Oleg-mk/JLR-MOST-Reader/kit/1_boards/README.md

# Плати: замовлення, деталі, монтаж

| Файл | Що це |
|---|---|
| `most_reader-gerbers.zip` | сама плата для фабрики: Gerber-файли, свердління, файл задачі |
| `most_reader-bom-jlcpcb.csv` | перелік деталей для монтажу SMD у JLCPCB, з номерами LCSC |
| `most_reader-cpl-jlcpcb.csv` | розміщення для JLCPCB, з їхніми поворотами |
| `most_reader-bom.csv` | повний перелік деталей, разом із ручними |
| `most_reader-schematic.pdf` | схема |
| `most_reader-assembly.pdf` | креслення верхнього боку: позначення всіх деталей (і восьми, яких не видно на шовкографії), знаки полярності, контур |

Ці файли — копії з `reader_hw/fab`. Їх пише `reader_hw/make_fab.py` з плати KiCad, руками не
правити.

## Плата

- 77.5 x 55.6 мм, 2 шари, FR-4 1.6 мм, мідь 1 oz з обох боків. JLCPCB покаже 77.6 x 55.7 мм, бо
  рахує контур разом із товщиною лінії.
- Доріжки від 0.2 мм, зазор 0.15 мм, найменший отвір 0.3 мм, вирізів немає.
- Маска з обох боків, шовкографія лише зверху. Покриття ENIG: U4 (VSSOP-8, крок 0.5 мм), U5
  (WSON-6) і U6 (HSOP-8) потребують плоских площадок.

## Замовлення на JLCPCB

1. **Плата.** Завантажити `most_reader-gerbers.zip`. Вибрати: 2 шари, 1.6 мм, 1 oz, ENIG, зелена
   маска, білий друк, кількість (10 для початку).
2. **Монтаж.** Лише верхній бік, «Confirm parts placement» увімкнути, своїх деталей не давати.
3. **BOM і CPL.** Завантажити `most_reader-bom-jlcpcb.csv` і `most_reader-cpl-jlcpcb.csv`: 28 рядків,
   усі з номерами LCSC, 50 деталей на плату. JLCPCB одразу покаже наявність. Якої деталі не
   вистачає, ту докупити з LCSC на тій самій сторінці.
4. **Перегляд розміщення перед оплатою.** Перевірити:
   - першу ніжку U1, U3 (SOT-353), U4 (VSSOP-8), U5 (WSON-6) і U6 (HSOP-8);
   - полярність D1, D2, D3, C44, C45 і C63.

   Повороти взято з посадок LCSC кожної вибраної деталі. Крапка першої ніжки U4 має стояти на
   позначці першої ніжки плати, а «+» кожного електроліта на боці «+» шовкографії.

## Деталі для ручного монтажу

На одну плату:

| Позиція | Деталь | Номер | Де купити |
|---|---|---|---|
| J1 | оптичний модуль MOST (pigtail FOT, 2+0) | TE 1-1394640-1 | у каталогах Mouser і DigiKey не знайдено, лише маркетплейси: шукати заздалегідь |
| J4 | Micro-Fit 3.0, 2 контакти, кутовий | Molex 43650-0200 | будь-який дистриб'ютор Molex |
| J6 | передавач TOSLINK, корпус T10 | Everlight PLT237/T10WH | DigiKey 1080-PLT237/T10WH-ND; у LCSC — C17296340 |
| M1 | модуль FPGA | Sipeed Tang Nano 20K | магазин Sipeed |
| — | гребінки 1x20 з кроком 2.54 мм, 2 шт. | — | зазвичай ідуть з модулем |

Отвори зроблено саме під ці деталі, схожі можуть не стати.

## Що ще потрібно, крім плати

- **Живлення J4:** корпус Molex 43645-0200 і два контакти 43030 (провід 20–24 AWG). Живити від
  постійного «плюса» акумулятора (KL30) і маси. Без живлення обхід не працює, і кільце машини
  розірване. Біля точки підключення до проводки машини варто поставити свій запобіжник: F1 на
  платі (2 А) захищає лише те, що за ним, а не провід.
- **Вставка в кільце MOST:** кабель, що розриває кільце біля одного з вузлів і заводить його на
  J1, а оптика назад іде насквозь. У репозиторії номера немає; такі кабелі роблять Kufatec,
  Dension, Trioma, і підбирати його треба під свій вузол.
- **Оптичний кабель TOSLINK** від J6 до DSP або підсилювача.
- **4 гвинти M3 або стійки** для H1..H4: довкола отворів лише земля.
- **Для стола** потрібне світло в J1: живе кільце машини або інша плата MOST. Без нього FPGA не
  отримує живлення від плати.

## Монтаж

1. Перед запаюванням записати в модуль Tang Nano 20K прошивку, через його USB-C, без плати
   (`2_fpga/README.md`).
2. J1, J4 і J6 паяти в будь-якому порядку, M1 останнім. Для M1: гребінки вставити в плату,
   модуль зверху, спершу паяти модуль, потім плату. Без панельок.
3. Орієнтація:
   - **M1:** квадратна площадка 1 і USB-C до верхнього краю, кінець із HDMI виступає за нижній
     край на 8 мм. Розвернутий на 180° модуль сів би землею на 5 В.
   - **J1:** площадка 1 (TXD) прямокутна, оптична грань за лівим краєм.
   - **J6:** порт до правого краю, виступає за нього на 2.35 мм, фіксатори перед ніжками.
     Площадка 1 (Vin) квадратна.
   - **J4:** площадка 1 (нижня, із заокругленими кутами) — VBAT, площадка 2 — GND. На шовкографії
     полярність не позначено.
4. Вісім дрібних позначень на шовкографії не вмістилися (C10, C17, C18, FB2, R1, R7, C47, C84).
   Вони є на кресленні монтажу.

## Перед першим живленням

- Оглянути все за списком із кроку 4 замовлення.
- Омметром перевірити, що немає короткого: J4 між 1 і 2, TP6 (3V3_AON) до TP9/TP10 (GND), TP7
  (5V_SW) до GND.
- Контакти 19 і 36 модуля (його власні 3.3 В) ні з чим не з'єднані. Так задумано.

## Перше живлення

1. J4 від лабораторного джерела 12 В з обмеженням струму: перевернута полярність пропалить F1.
2. TP6 має показати 3.3 В (U5, є завжди). Без світла в J1 сигнал WAKE = 0 і U6 вимкнено, тож
   TP7 = 0 В — так і має бути. Струм спокою — десятки мікроампер.
3. Зі світлом у J1 TP7 показує близько 5.3 В, модуль отримує близько 5.0 В через D3.
4. Коли FPGA стартує, з'являється 3V3_SW (ніжка 7 модуля, живлення J6): близько 3.2 В, не менше
   2.8 В.
   Світлодіоди модуля горять нулем:
   - LED1 не світить: його ніжка живить 3V3_SW;
   - LED0 — кільце захоплено;
   - LED2 — іде потік кадрів;
   - LED3 — парність відома;
   - LED4 — блимає на кожне наше повідомлення;
   - LED5 — викинутий блок або перевантаження.
5. Далі стіл із ноутбуком: `3_laptop/README.md`, «Перед машиною».

## У машині

Спершу лише обхід: зчитувач у кільці, з живленням, а машина звучить як раніше. Потім уже
зчитувач із записом поїздки.
