Oleg-mk/JLR-MOST-Reader/kit/2_fpga/README.md

# FPGA зчитувача: прошивка для Tang Nano 20K

- `reader.fs` — бітстрім зчитувача для GW2AR-LV18QN88C8/I7 на модулі Sipeed Tang Nano 20K.
- `BUILD.txt` — з якого коміту його зібрано, його номер (`build_id`), UserCode, частота
  читання флешу (25 МГц) і таймінг збірки.

Бітстрім пишеться у SPI-флеш модуля. FPGA читає його звідти щоразу, коли прокидається кільце
(близько 290 мс), тож запис у флеш переживає вимкнення. Запис в SRAM для зчитувача не годиться:
він зникає разом із живленням.

`tools/make_kit.py --fpga` бере сюди лише бітстрім, зібраний із закомічених джерел і з
запасом таймінгу не менше 10 %. `check_all.py` падає, якщо джерела змінилися після цієї збірки.

## Коли заливати

Найкраще до того, як модуль запаяно в плату: модуль підключається до ноутбука USB-C, без
плати. Що робить заводська демо-прошивка модуля з ніжками 16, 27 і 42, проєкт не перевіряв.
Ніжка 16 у платі живить U3 і J6, а ніжку 27 веде U3. Пізніше прошивку можна оновлювати й у
платі тим самим USB-C.

Перед записом треба закрити `ring_log` (`record`), бо JTAG і відкритий порт моста
виключають одне одного. Після запису висмикнути й вставити USB.

## Прошивка відладчика BL616

Міст USB на модулі має власну прошивку. Потрібна версія 2025030317 або новіша: зі старішими
`openFPGALoader` не пише флеш, а порт працює вчетверо швидше, ніж задано. Як дізнатися версію:
`3_laptop/README.md`, «Перед машиною», крок 1. Оновлюється вона програмою BouffaloLabDevCube
(Windows і macOS): вибрати чип BL616/618 і вставити USB, тримаючи кнопку UPDATE за роз'ємом
HDMI. Покроково: wiki.sipeed.com, сторінка «update_debugger».

## Windows 10 або 11: Gowin Programmer

1. Gowin Programmer входить у Gowin EDA (Education, з gowinsemi.com) або ставиться окремо з
   пакета Sipeed (dl.sipeed.com, TANG, programmer). Драйвер FTDI ставиться разом із ним.
2. Модуль підключити прямо в порт ПК, без хаба. У Диспетчері пристроїв мають з'явитися
   USB Converter A, USB Converter B і COM-порт.
3. Запустити Programmer:
   - **Cable Setting:** кабель, який він знайшов (USB Debugger A), частота 2.5 МГц або менше,
     Save.
   - **Scan:** у списку вибрати **GW2AR-18C**, бо GW2A-18C і GW2ANR-18C мають той самий ID.
   - Подвійне клацання в колонці Operation, далі:
     - Access Mode: **External Flash Mode**;
     - Operation: **exFlash Erase,Program thru GAO-Bridge**;
     - File: `reader.fs`;
     - External Flash Device: **Generic Flash**;
     - Start Address: **0x000000**.
     Save, потім Program/Configure.
   - Операції з «Verify» Sipeed радить не вибирати: з цим мостом вони бувають дуже повільні або
     обриваються. Перевірка нижче.
4. Те саме з командного рядка, з папки `Programmer\bin`:

   ```bat
   programmer_cli.exe --scan-cables
   programmer_cli.exe --cable-index 4 --frequency 2.5MHz --device GW2AR-18C --run 36 --spiaddr 0x000000 --fsFile C:\шлях\до\kit\2_fpga\reader.fs
   ```

   `--cable-index` береться той, під яким `--scan-cables` показав USB Debugger A.

## macOS (і Apple Silicon): openFPGALoader

1. Встановити Homebrew (brew.sh), далі `brew install openfpgaloader`.
2. Модуль підключити до Mac. На Mac з Apple Silicon на питання про новий аксесуар відповісти
   «Дозволити».
3. Перевірити зв'язок: `openFPGALoader -b tangnano20k --detect`. Має показати idcode 0x0000081b.
4. Записати флеш:

   ```bash
   openFPGALoader -b tangnano20k -f --verify reader.fs
   ```

   Якщо пише «unable to claim usb device», повторити з `sudo`: драйвер Apple тримає міст, і
   відпустити його може лише root. Вивантажувати драйвер Apple не треба.
5. Висмикнути й вставити USB, після чого порт моста `/dev/cu.usbserial-…` з'явиться знову.

Gowin Programmer під macOS існує, але з цим мостом на Mac його не перевіряли.

## Перевірка, що працює саме цей бітстрім

- **З ноутбуком:** запустити `record` (`3_laptop`). Номер `build` у рядку стану (одразу після
  `held`) має дорівнювати `build_id` з `BUILD.txt`; після розбору він є і в `summary.txt`
  («build IDs»). Перша цифра 8..F означала б збірку з незакоміченими змінами. На
  столі без кільця `held1` — це нормально: FPGA повторює холодний старт.
- **Через JTAG:** Gowin Programmer, «Read User Code», має показати `usercode` з `BUILD.txt`.
- **Без ноутбука, у платі:** 3V3_SW (ніжка 7 гребінки модуля, живлення J6) з'являється, коли FPGA
  сконфігурувалася з флешу бітстрімом зчитувача, будь-якою його збіркою; котрою саме, кажуть лише
  `build` у лозі або UserCode через JTAG. Від першого фронту на кільці до появи 3V3_SW за таблицею
  Gowin близько 290 мс; справжню цифру дає вимір COLD. Світлодіоди без кільця ні про що не кажуть.
  У машині LED0 (захоплення), LED2 (потік кадрів) і LED3 (парність) світяться, коли все працює.

## Своя збірка

Збирати самому не обов'язково. Хто хоче: Gowin EDA 1.9.12.03, `python reader_gw/board/build.py` у
репозиторії (збирає й перевіряє таймінг), потім `python tools/make_kit.py --fpga`.
