Oleg-mk/JLR-MOST-Reader/reader_hw2/kit/1_boards/README.md

# Плати v2.0: замовлення, деталі, труба, монтаж

| Файл | Що це |
|---|---|
| `most_reader_v2-gerbers.zip` | сама плата для фабрики: Gerber-файли, свердління, файл задачі |
| `most_reader_v2-bom-jlcpcb.csv` | перелік деталей для монтажу SMD у JLCPCB, з номерами LCSC |
| `most_reader_v2-cpl-jlcpcb.csv` | розміщення для JLCPCB: нижній бік, з їхніми поворотами |
| `most_reader_v2-bom.csv` | повний перелік деталей, разом із ручними |
| `most_reader_v2-schematic.pdf` | схема |
| `most_reader_v2-assembly-bottom.pdf` | нижній бік, як його видно знизу: позначення всіх SMD-деталей, J4 і J6, знаки полярності, контур |
| `most_reader_v2-assembly-top.pdf` | верхній бік: J1 і M1, куди дивляться їхні грані |
| `caps/ring_cap.stl`, `caps/ring_cap.step` | кільцева кришка труби (з боку J1), для друку |
| `caps/far_cap.stl`, `caps/far_cap.step` | дальня кришка (USB-C модуля, J6, J4), для друку |
| `caps/caps.svg` | креслення обох кришок: вигляд ззовні, розріз, вигляд знизу, розміри, примітки |

Ці файли — копії з `reader_hw2/fab` і `reader_hw2/caps`. Їх пишуть `reader_hw2/make_fab.py` з плати
KiCad і `reader_hw2/gen_caps.py` з моделі плати в трубі (`check_fit.py`), руками не правити.

## Плата

- 84.9 x 26.5 мм, 2 шари, FR-4 1.6 мм, мідь 1 oz з обох боків. JLCPCB покаже 85.0 x 26.6 мм, бо
  рахує контур разом із товщиною лінії.
- Доріжки від 0.2 мм, зазор 0.15 мм, найменший отвір 0.3 мм, вирізів немає.
- Усі SMD-деталі знизу, зверху лише J1 і M1. Верхній шар — земля.
- Маска й шовкографія з обох боків. Покриття ENIG: U4 (VSSOP-8, крок 0.5 мм), U5 (WSON-6) і U6
  (HSOP-8) потребують плоских площадок.

## Замовлення на JLCPCB

1. **Плата.** Завантажити `most_reader_v2-gerbers.zip`. Вибрати: 2 шари, 1.6 мм, 1 oz, ENIG,
   зелена маска, білий друк, кількість (10 для початку).
2. **Монтаж.** Лише **нижній** бік (Bottom), «Confirm parts placement» увімкнути, своїх деталей
   не давати.
3. **BOM і CPL.** Завантажити `most_reader_v2-bom-jlcpcb.csv` і `most_reader_v2-cpl-jlcpcb.csv`:
   30 рядків, усі з номерами LCSC, 52 деталі на плату. Деталі ті самі, що у v1.0, плюс R43
   (33 Ом, та сама позиція, що R28), R44 (68 Ом, C27592) і новий C45 (47 мкФ 63 В 8x10, SamYoung
   MVK, C165628). JLCPCB одразу покаже наявність. Якої
   деталі не вистачає, ту докупити з LCSC на тій самій сторінці.
4. **Перегляд розміщення перед оплатою.** JLCPCB показує нижній бік так, як його видно знизу.
   Перевірити:
   - першу ніжку U1, U3 (SOT-353), U4 (VSSOP-8), U5 (WSON-6) і U6 (HSOP-8);
   - полярність D1, D2, D3, C44, C45 і C63.

   Поворот деталі нижнього боку дорівнює 180° мінус кут у KiCad плюс поворот самої деталі з її
   посадки LCSC: 180° для SOT-353, 270° для U4 і U6, 0° для решти. Так рахує й плагін
   kicad-jlcpcb-tools, і для всіх 52 деталей це звірено з їхніми площадками. Крапка першої ніжки
   U4 має стояти на позначці першої ніжки плати, а «+» кожного електроліта — на боці «+»
   шовкографії.

## Деталі для ручного монтажу

На одну плату:

| Позиція | Деталь | Номер | Де купити |
|---|---|---|---|
| J1 | оптичний модуль MOST (pigtail FOT, 2+0) | TE 1-1394640-1 | у каталогах Mouser і DigiKey не знайдено, лише маркетплейси: шукати заздалегідь |
| J4 | Micro-Fit 3.0, 2 контакти, кутовий | Molex 43650-0200 | будь-який дистриб'ютор Molex |
| J6 | передавач TOSLINK, корпус T10 | Everlight PLT237/T10WH | DigiKey 1080-PLT237/T10WH-ND; у LCSC — C17296340 |
| M1 | модуль FPGA | Sipeed Tang Nano 20K | магазин Sipeed |
| — | гребінки з кроком 2.54 мм, лише 9 контактів: дві смужки 1x20 нарізати шматками 5, 7–8, 20 і 21–22, 25, 35, 40 | — | зазвичай ідуть з модулем |

Отвори зроблено саме під ці деталі, схожі можуть не стати.

## Труба і кришки

- Алюмінієва квадратна труба 30x30x1.5 (27.0 мм всередині), довжина 84.9 мм (+0.2/−0), торці рівні
  й без задирок. Плата 26.5 мм завширшки, з боків лишається по 0.25 мм. Краще без покриття (БП):
  анодування ізолює, а трубу з'єднуємо з землею (нижче).
- Кришки друкуються з `caps/`: STL для слайсера, STEP для CAD, креслення в `caps/caps.svg`. Матеріал
  PETG або ASA (PLA у машині, що стоїть на сонці, м'якне), або замовити друк MJF PA12. Друкувати
  зовнішньою гранню на стіл, без підтримок (сідло росте від столу разом із фланцем); стінки не тонші
  1.2 мм.
- Кожна кришка — фланець 30x30, 2.0 мм, що лягає на торець труби, плюс блок усередину. Плата
  впирається торцями у фланці.
- Знизу фланець переходить у сідло під трубою: 3 мм завтовшки, 9 мм уздовж труби від торця, з вухом
  по 10 мм з кожного боку й отвором Ø4.2 у кожному вусі. Труба лежить дном на двох сідлах, а чотири
  гвинти крізь вуха кріплять зчитувач у машині: саморізи 4.2 мм (DIN 7981) або M4, голова не більша
  за 8.2 мм.
  - Кільцева: корпус J1 проходить крізь неї і виходить на 1.6 мм. Блок під платою тримає її низ на
    11.47 мм від дна труби. Поздовжній паз у блоці пропускає фіксатор J1, а сам блок обходить
    action pins J1.
  - Дальня: у ній виріз під USB-C модуля (його грань урівень із зовнішньою гранню кришки) і один
    спільний виріз під корпус J6 і грань J4 (перемичка між двома окремими вийшла б 0.4 мм). Блок
    стоїть над кінцем модуля, на 0.5 мм вище USB-C.
- Фіксація: по одному саморізу M2x6 на кришку. Отвір Ø2.2 у стінці труби, а в блоці свердлити
  Ø1.6 вже при складанні: кільцева — у дні труби, 4.2 мм від торця, по осі, крізь отвір Ø5.0 у її
  сідлі (голова саморіза ховається в товщині сідла); дальня — у стелі, 3.0 мм від торця, по осі.
- Земля труби, біля J4: під голову саморіза дальньої кришки покласти кільцевий наконечник M2 і
  зубчасту шайбу, від наконечника провід 3–5 см до мінусового проводу джгута J4 біля самої колодки
  (пайка, термоусадка). Це той самий вузол GND, що й контакт 2 J4. На самій платі біля J4 місця
  для такого з'єднання немає: уздовж обох довгих країв ідуть гребінки модуля, а торець займають J4
  і J6. Анодовану трубу під шайбою зачистити до металу.

## Перед замовленням виміряти

Цифри для труби й кришок стоять на кількох припущеннях. Перевірити, у порядку ваги:

- трубу всередині (27.0 мм за номіналом) і радіус її внутрішніх кутів (взято до 1.0 мм);
- модуль: наскільки HDMI і USB-C виступають за його плату (взято 4 і 2 мм) і найвищу деталь на
  його нижньому боці біля USB-C (взято 2.0 мм: під нею обрізані виводи J6 і J4);
- довжину хвостів і фіксатора J4 під площиною посадки (взято 3.0 мм);
- товщину кришок біля вирізів (взято 2.0 мм): USB-C модуля має закінчуватися на зовнішній грані
  дальньої кришки.

## Що ще потрібно, крім плати

- **Живлення J4:** корпус Molex 43645-0200 і два контакти 43030 (провід 20–24 AWG). Живити від
  постійного «плюса» акумулятора (KL30) і маси. Без живлення обхід не працює, і кільце машини
  розірване. Біля точки підключення до проводки машини варто поставити свій запобіжник: F1 на
  платі (2 А) захищає лише те, що за ним, а не провід.
- **Вставка в кільце MOST:** кабель, що розриває кільце біля одного з вузлів і заводить його на
  J1, а оптика назад іде насквозь. У репозиторії номера немає; такі кабелі роблять Kufatec,
  Dension, Trioma, і підбирати його треба під свій вузол.
- **Оптичний кабель TOSLINK** від J6 до DSP або підсилювача.
- **Труба і дві кришки** за розділом вище, два саморізи M2x6, кільцевий наконечник M2, зубчаста
  шайба M2 і 3–5 см проводу 20–22 AWG для землі труби.
- **Кріплення в машині:** чотири саморізи 4.2 мм (DIN 7981) або гвинти M4 крізь вуха сідел.
- **Для стола** потрібне світло в J1: живе кільце машини або інша плата MOST. Без нього FPGA не
  отримує живлення від плати.

## Монтаж

1. Перед запаюванням записати в модуль Tang Nano 20K прошивку, через його USB-C, без плати
   (`2_fpga/README.md`).
2. **J6 і J4** вставити знизу (корпуси на нижньому боці) і паяти зверху. Там, де ляже модуль,
   їхні виводи і фіксатор J4 зрізати врівень із платою: після модуля до них не підлізти.
3. **J1** поставити зверху на кільцевому краї, паяти знизу.
4. **M1** паяти останнім, лише на 9 контактах: 5, 7, 8, 20 в одному ряду і 21, 22, 25, 35, 40 в
   іншому. Решти отворів на платі немає. Смужки нарізати шматками (5 | 7–8 | 20 і 21–22 | 25 | 35 |
   40), вставити їх у плату, модуль зверху: плата тримає шматки рівно. Спершу паяти модуль, потім
   плату знизу. Без панельок.
5. Орієнтація:
   - **M1:** USB-C на дальньому краї, виступає за нього на 2 мм; кінець із HDMI дивиться до J1.
   - **J1:** оптична грань за кільцевим краєм, корпус виступає на 3.6 мм.
   - **J6:** порт на дальньому краї. Площадка 1 (Vin) квадратна.
   - **J4:** на дальньому краї, поруч із J6. Площадка 1 (із заокругленими кутами) — VBAT,
     площадка 2 — GND.
6. Усі позначення є на шовкографії, і ті самі — на кресленнях монтажу.

## Перед першим живленням

- Оглянути все за списком із кроку 4 замовлення.
- Омметром перевірити, що немає короткого: J4 між 1 і 2, C3 (3V3_AON) між площадками, C63
  (5V_SW) між «+» і «−». Контрольних площадок (TP) на цій платі немає, міряти на цих деталях.
- Контакти 19 і 36 модуля (його власні 3.3 В) ні з чим не з'єднані. Так задумано.

## Перше живлення

На столі, поза трубою.

1. J4 від лабораторного джерела 12 В з обмеженням струму: перевернута полярність пропалить F1.
2. C3 має показати 3.3 В (U5, є завжди). Без світла в J1 сигнал WAKE = 0 і U6 вимкнено, тож на
   C63 0 В — так і має бути. Струм спокою — десятки мікроампер.
3. Зі світлом у J1 на «+» C63 близько 5.3 В, модуль отримує близько 5.0 В через D3.
4. Коли FPGA стартує, з'являється 3V3_SW (ніжка 7 модуля, живлення J6): близько 3.2 В, не менше
   2.8 В. Світлодіоди модуля горять нулем:
   - LED1 не світить: його ніжка живить 3V3_SW;
   - LED0 — кільце захоплено;
   - LED2 — іде потік кадрів;
   - LED3 — парність відома;
   - LED4 — блимає на кожне наше повідомлення;
   - LED5 — викинутий блок або перевантаження.
5. Далі стіл із ноутбуком: `3_laptop/README.md`, «Перед машиною».
6. Після стола плата йде в трубу. Великі електроліти C44 і C45 варто прихопити до плати клеєм:
   у машині трясе.
7. Складання в трубу: дальню кришку надіти й закріпити саморізом, поклавши під його голову
   кільцевий наконечник проводу землі із зубчастою шайбою. Плату всунути з кільцевого торця, поки
   її дальній край не впреться у фланець, а USB-C, J6 і J4 не стануть у вирізи. Потім надіти
   кільцеву кришку: її блок іде під плату, фіксатор J1 проходить пазом. Закріпити саморізом.
8. Провід від наконечника припаяти до мінусового проводу джгута J4 біля колодки й закрити
   термоусадкою. Омметром: між трубою і контактом 2 J4 — нуль.

## У машині

Зчитувач кріпиться дном труби донизу, чотирма гвинтами крізь вуха сідел. Спершу лише обхід:
зчитувач у кільці, з живленням, а машина звучить як раніше. Потім уже зчитувач із записом поїздки.
