Oleg-mk/JLR-MOST-Reader/reader_hw2/kit/README.md

# Комплект зчитувача MOST для JLR, v2.0: плата в трубі

Тут лежить усе, щоб зробити зчитувач v2.0 і з'їздити з ним, без решти репозиторію. Зчитувач
стоїть у кільці MOST25 машини, читає звук і команди керування, а віддає S/PDIF через TOSLINK.
v2.0 — це схема v1.0 плюс два послідовні резистори (R43, R44) і менший C45 (47 мкФ, 8x10) на
платі 84.9 x 26.5 мм. Плата
входить в алюмінієву трубу 30x30x1.5 із двома торцевими кришками. Прошивка FPGA і програми
ноутбука ті самі, що у v1.0. Зроблено під Jaguar XF X250 за повідомленнями, які бачили відкриті
проєкти; у машині ще не перевірено.

| Папка | Що всередині |
|---|---|
| `1_boards/` | замовлення плат на JLCPCB з монтажем SMD знизу; деталі для ручного монтажу; труба і вирізи кришок; схема, креслення монтажу, перевірки перед живленням |
| `2_fpga/` | прошивка FPGA (`reader.fs`) і як записати її в Tang Nano 20K з Windows або macOS |
| `3_laptop/` | програма запису поїздки й розбору вдома, для Windows 10/11 і macOS (і на Apple Silicon) |

## Порядок

1. **Виміри.** Труба, модуль, J4 і кришки за `1_boards/README.md`, розділ «Перед замовленням
   виміряти».
2. **Плати.** Замовити за `1_boards/README.md`. Окремо купити деталі для ручного монтажу і трубу,
   зробити кришки.
3. **FPGA.** Ще до запаювання модуля Tang Nano 20K записати в нього `reader.fs`
   (`2_fpga/README.md`).
4. **Монтаж.** Запаяти ручні деталі в порядку з `1_boards/README.md`, зробити перевірки перед
   живленням, увімкнути вперше на столі.
5. **Стіл.** Без ноутбука виміряти DARK і COLD. З ноутбуком провести тривалий тест лінії, на тому
   ноутбуці, що поїде (`3_laptop/README.md`, «Перед машиною»). Потім плата йде в трубу.
6. **Машина.** Спершу лише обхід: зчитувач у кільці, живлення є, а машина звучить як раніше.
   Далі зчитувач із записом.

## Звідки ці файли

Комплект збирає з репозиторію команда `python tools/make_kit.py --v2 <папка>`.

- `1_boards` — копії з `reader_hw2/fab`, їх пише `reader_hw2/make_fab.py` з плати KiCad.
- `2_fpga` і `3_laptop` — ті самі папки, що в комплекті v1.0 (`kit/` репозиторію). Схема та сама:
  `tools/check_v2_circuit.py` звіряє її з v1.0 деталь за деталлю і коло за колом. Тому і бітстрім
  той самий.
- Пояснення (`README.md` тут і в `1_boards`) написано вручну, вони лежать у `reader_hw2/kit/`.

Повні описи лежать у репозиторії: `README.uk.md` (опис проєкту), `reader_hw2/README.md`
(плата v2.0 і труба), `reader_gw/README.md` (FPGA), `reader_gw/LOGGING.md` (запис).
