Oleg-mk/JLR-MOST-Reader/kit/3_laptop/README.md

# Ноутбук: запис поїздки і розбір удома

Дві програми на Python:

- `ring_log.py` пише все, що зчитувач шле через USB модуля Tang Nano 20K: блоки
  керуючого каналу, рішення декодера, стан приймача кожні 21 мс, події, знімки лінії. Ще він
  ставить позначки й пищить при збоях.
- `log_decode.py` розбирає записану поїздку на читабельні файли. Записані блоки він проганяє
  через модель декодера і порівнює з тим, що вирішила FPGA.

Решта файлів (`log_format.py`, `ctrl_model.py`, `gain_tables.py`, `virtual_most_source/`) потрібні
цим двом. Це копії з репозиторію, редагувати їх тут не треба: `tools/make_kit.py` тримає їх
однаковими з джерелами. Повний опис запису (що в кожному записі, команди FPGA):
`reader_gw/LOGGING.md` у репозиторії; для роботи з комплектом його не треба.

## Яка система

| | Windows 10 або 11 | macOS (і на Apple M1..M4) |
|---|---|---|
| Програми | так | так |
| Драйвер моста USB | FTDI, ставиться сам з Windows Update | вбудований у macOS, нічого не ставити |
| Порт для поїздки | звичайний USB-A, кабель A-C | лише USB-C: див. «Mac у поїздці» |
| Кришка під час поїздки | у живленні задати «кришка: нічого не робити» | **не закривати**: MacBook на батареї засинає |
| Перевірено на столі | ще ні | ще ні |

Обидві системи ще належить перевірити на столі з живою платою (тривалий тест нижче). На Mac
окремо не доведено, що вбудований драйвер Apple тримає 3 000 000 бод цього моста.

## Python

Потрібен Python 3.8 або новіший. Найкраще поставити свіжий 3.14 з python.org.

- **Windows 10/11:** інсталятор `python-3.14.x-amd64.exe` з python.org, у першому вікні
  поставити галочку «Add python.exe to PATH». Python 3.8–3.12 теж працюватиме, але на Windows
  час у файлах тоді йде кроками по 15.6 мс.
- **macOS:** пакет `python-3.14.x-macos11.pkg` з python.org: він працює і на Apple Silicon.
  `/usr/bin/python3` від Apple (3.9) теж підійде, але він працює лише після
  `xcode-select --install`; простіше поставити пакет з python.org.

pyserial ставити руками не треба. Перший запуск `record` сам робить поруч папку `.venv` і ставить
туди pyserial, тому тоді потрібен інтернет. Далі все працює без мережі.

## Запис

- **Windows:** подвійне клацання по `record.bat`.
- **macOS:** відкрити Термінал, перетягнути цю папку у вікно після `cd ` і натиснути Enter, далі
  `bash record.command`. Щоб працювало й подвійне клацання по `record.command`, один раз
  виконати в цій папці `chmod +x *.command` і, якщо файли завантажено з інтернету,
  `xattr -d com.apple.quarantine *.command`.

Додаткові параметри запису, які мають діяти щоразу (виміряні DARK і COLD, порт), записати одним
рядком у файл `record_args.txt` поруч, наприклад `--dark-ms 104 --cold-ms 290`. `record` додає
їх сам.

Файли поїздки лягають у `logs/` поруч: `<дата>-<час>-<n>.bin` (самі байти лінії), `.idx` (час ПК
для кожного шматка) і `<дата>-<час>.marks.txt` (позначки й нотатки). Після кожного
перепідключення починається новий шматок `-n`. Місце на диску: близько 0.6 ГБ на годину
звичайної їзди, до 1.1 ГБ при повній лінії.

Порт шукається сам, за USB-ідентифікатором моста. Явно його можна задати в `record_args.txt`:
`--port COM7` або `--port /dev/cu.usbserial-XXXX1`.

### Клавіші

| Клавіша | Що робить |
|---|---|
| `m` | позначка: пищить, на екрані велике число; номер іде і в FPGA, разом зі знімком кадрів |
| `n` | нотатка до останньої позначки, набирається в рядку стану, Enter завершує |
| `r` / `f` | знімок лінії / знімок кадрів зараз |
| `t` | тривалий тест лінії: увімкнути / вимкнути |
| `q` | вийти (питає `y/n`); Ctrl+C теж питає |

Клавіші працюють і в українській розкладці (ь, т, к, а, е, й, н), і з Caps Lock. Під час
позначки зручно вголос надиктувати на телефон, що показує екран (гучність тощо), назвавши номер.

### Рядок стану

`lock1 known1 run1 par1 laptop1 held0 build 0171035C | mark 3 holes 0 drop 0 port 0 cmd 0 | blk ...`

- `lock`: приймач захопив кільце. `known`: межі блоків відомі. `run`: потік кадрів іде.
  `par`: парність відома.
- `laptop`: FPGA бачить ноутбук. `held 1`: ядро тримається в скиданні, бо FPGA повторює
  вимкнення живлення, як без ноутбука (далі «Ноутбук і холодний старт»).
- `holes` — дірки в записах, `drop` — записи, які довелося викинути FPGA, `port` — скільки разів
  губився порт, `cmd` — команди без відповіді. У нормальному записі всі чотири дорівнюють 0.
- `build`: номер прошивки. Він має збігатися з `build_id` у `2_fpga/BUILD.txt`.
- Тривоги стоять на самому початку рядка, поки тривають: `DISK ERROR ...` (помилка диска) і
  `only the JTAG's port ...` (див. «Перед машиною», крок 2). `fill` у рядку означає, що йде
  тривалий тест лінії.

Рядок обрізається по ширині вікна, і найважливіше стоїть на початку. Головне вміщується в
100 знаків, а весь рядок — у 190.

### Звуки

Високий короткий — позначка. Низькі довгі — тривога: втрачено порт, дірка в записах, FPGA
викинула записи, FPGA почала спочатку, команда без відповіді, помилка диска. Що саме сталося,
видно в рядку стану.

## Ноутбук і холодний старт

Без ноутбука кільце засинає разом із живленням FPGA, а при пробудженні FPGA стартує з нуля.
З ноутбуком модуль живився б від USB і цей старт ховався б. Тому FPGA, поки бачить ноутбук,
сама повторює вимкнення: DARK мс без світла тримають ядро в скиданні, ще COLD мс після першого
фронту. `record` передає ці часи: `--dark-ms 100 --cold-ms 300`, доки їх не виміряно на столі.
Після вимірів справжні цифри записати в `record_args.txt` (див. «Запис»).

## Перед машиною (на столі)

1. **Міст модуля.** Прошивка відладчика BL616 має бути 2025030317 або новіша, бо старі
   множать швидкість порту на 4.
   - Windows: Диспетчер пристроїв, USB Converter A, Подробиці, «Батьківський»: останні 10 цифр.
   - macOS: `ioreg -p IOUSB -l -w0 | grep -E '"USB Serial Number"|"bcdDevice"'`, останні 10 цифр
     серійного номера.
   - Оновлення: `2_fpga/README.md`.
2. **Порт у Windows.** У Диспетчері пристроїв мають бути два конвертери і COM-порт. Якщо
   програма пише «only the JTAG's port», треба зайти в USB Serial Converter B, Властивості,
   Додатково, поставити «Load VCP» і перепідключити.
3. **DARK і COLD** виміряти без ноутбука: USB модуля не під'єднано, модуль живиться лише від
   плати. Потрібні осцилограф і світло в J1 (живе кільце машини або інша плата MOST); світло
   вимикається й вмикається, коли висмикнути й вставити оптику J1.
   - Точки: RX_BUF — вихід U1 (його ніжка 4); WAKE — ніжка 2 (EN) мікросхеми U6, вона ж вихід U4;
     3V3_SW — ніжка 7 гребінки модуля або ніжка 2 J6.
   - **DARK** = від останнього фронту RX_BUF (оптику висмикнули) до спаду WAKE. За схемою
     близько 0.1 с (R6 100 кОм x C9 1 мкФ).
   - **COLD** = від першого фронту RX_BUF (оптику вставили) до появи 3V3_SW. За таблицею Gowin
     близько 0.3 с, разом зі стартом перетворювача.
   - Обидва числа в мілісекундах записати в `record_args.txt`: `--dark-ms 104 --cold-ms 290`.
4. **Тривалий тест** на тому ноутбуці, з тим кабелем і портом, що поїдуть у машину, на батареї.
   Запустити `record` з `--auto-mark 5` (позначка зі знімком кадрів кожні 5 с) і натиснути `t`:
   - 2 години так (проміжок між записами тесту `--fill-gap 25`, як навантаження в поїздці);
   - 10 хвилин на повну лінію (`--fill-gap 0`);
   - модуль живиться від стендових 5 В через ніжку 21 гребінки, USB висмикнути на хвилину і
     вставити: порт має повернутися сам;
   - один раз приспати і розбудити ноутбук.
   Пройдено, якщо у `summary.txt` після розбору: `holes: 0`, `bytes not in records: 0`,
   `records the FPGA dropped: 0`, і STATUS іде кожні 21 мс. Байти на початку кожного шматка, де
   порт відкрився посеред запису, рахуються окремо («at the segments' starts») і на тест не
   впливають. Наприкінці тесту знову `t`, щоб FPGA перестала його слати.

## Mac у поїздці

LOGGING.md дозволяє в машині лише порт USB-A. Плата сама тримає 5 В на USB модуля, тож порт
USB-C, який відвалився під час їзди, може не під'єднатися знову, поки кільце не засне. У MacBook
є тільки USB-C. Тому:

1. На столі пройти крок 4 саме з цим Mac і кабелем. Головне — висмикнути USB, коли модуль
   живиться від 5 В, і перевірити, що порт повертається сам.
2. Якщо не повертається, поставити між Mac і модулем USB-хаб із власним живленням і портами USB-A
   і повторити. Це припущення, його ще ніхто не перевіряв.
3. Якщо і так не повертається, у поїздку брати ноутбук з Windows і портом USB-A.

На Mac під час поїздки кришку тримати відкритою. Щоб екран не гас і Mac не засинав,
програма сама запускає `caffeinate`. Коли Mac з Apple Silicon уперше бачить модуль, він питає
«Дозволити аксесуару під'єднатися?», і треба відповісти «Дозволити».

## У машині

- Ноутбук на власній батареї, сон вимкнено. На Windows ще вимкнути «вибіркове призупинення USB»
  (Електроживлення, Додаткові параметри, Параметри USB).
- Один пасивний кабель, якомога коротший.
- Запис почати, коли машина замкнена і кільце спить, щоб перше пробудження потрапило у файл.
- Порт не відкривати іншою програмою (термінали, Gowin Programmer).
- Позначку ставити на кожну дію: гучність вгору і вниз, підказка навігації, телефон, задній хід,
  а також на кожен службовий сигнал (ключ, ремінь, двері). Задній хід і сигнали покажуть, чи йдуть
  звуки парктроніка й сигнали по кільцю як звук (приймачі 3 і 4), чи командами, з яких підсилювач
  робить звук сам.

## Розбір удома

- **Windows:** подвійне клацання по `decode.bat` розбирає найновішу поїздку з `logs/` з усіма
  шматками. Якщо перетягнути на нього `.bin`, розбирається лише цей шматок.
- **macOS:** `bash decode.command` або `bash decode.command logs/<дата>-<час>`.

Результат лягає в `logs/<дата>-<час>.d/`; розбір одного шматка — у `logs/<дата>-<час>-<n>.d/`. Почати з `summary.txt` (записи, дірки, викинуте FPGA,
номери прошивки, підсумок звірки), далі `replay.txt` (рішення FPGA проти моделі). Ще там є
`telegrams.txt`, `blocks.csv`, `status.csv`, `events.txt`, `sets.txt` і знімки `dump_*`.
