Oleg-mk/JLR-MOST-Reader/reader_hw2/fab/most_reader_v2-bom-jlcpcb.csv

Comment | Designator | Footprint | LCSC Part # | Manufacturer Part
10u 100V | C1 | C_1210_3225Metric | C576517 | Murata GRM32EC72A106KE05L, X7S
100n 100V | C2,C43,C46,C47,C82,C83,C84 | C_0603_1608Metric | C15725 | Samsung CL10B104KC8NNNC, X7R
2u2 | C3 | C_0603_1608Metric | C23630 | Samsung CL10A225KO8NNNC, 16 V X5R
4u7 100V | C4 | C_1210_3225Metric | C385986 | Taiyo Yuden HMK325C7475KMHPE, X7S
100n | C6,C8,C10,C12,C17,C19,C31,C64,C85 | C_0603_1608Metric | C14663 | Yageo CC0603KRX7R9BB104, 50 V X7R
47u 10V | C7 | C_1210_3225Metric | C77101 | Murata GRM32ER61C476KE15L, 16 V X5R
1u | C9 | C_0603_1608Metric | C15849 | Samsung CL10A105KB8NNNC, 50 V X5R
10u | C18,C20 | C_0805_2012Metric | C15850 | Samsung CL21A106KAYNNNE, 25 V X5R
1u | C32 | C_0805_2012Metric | C28323 | Samsung CL21B105KBFNNNE, 50 V X7R
100u 63V | C44 | CP_Elec_10x10.5 | C53330124 | SamYoung CLZ 63V 100uF 10x10, 125 C
47u 63V | C45 | CP_Elec_8x10 | C165628 | SamYoung MVK 63V 47uF 8x10, 105 C
100u 16V | C63 | CP_Elec_6.3x7.7 | C359220 | SamYoung BLA 16V 100uF 6.3x6
SS34 | D1,D3 | D_SMA | C8678 | MDD SS34
SMBJ36A | D2 | D_SMB | C135070 | Diodes SMBJ36A-13-F
2A T | F1 | Fuse_1206_3216Metric | C2925010 | TLC F12T2, slow blow, 72 V
600R | FB1,FB2 | L_0603_1608Metric | C1002 | Sunlord GZ1608D601TF
15u | L1 | L_Bourns_SRN6045TA | C1330797 | Bourns SRN6045TA-150M
22u | L2 | L_Bourns-SRN8040_8x8.15mm | C2041547 | Bourns SRN8040-220M
150 | R1,R2 | R_0603_1608Metric | C22808 | UNI-ROYAL 0603WAF1500T5E
27k | R3,R42 | R_0603_1608Metric | C22967 | UNI-ROYAL 0603WAF2702T5E
100k | R4,R6,R7 | R_0603_1608Metric | C25803 | UNI-ROYAL 0603WAF1003T5E
23k2 | R5 | R_0603_1608Metric | C23346 | UNI-ROYAL 0603WAF2322T5E
33 | R28,R43 | R_0603_1608Metric | C23140 | UNI-ROYAL 0603WAF330JT5E
64k9 1% | R31 | R_0603_1608Metric | C14891 | UNI-ROYAL 0603WAF6492T5E
68 | R44 | R_0603_1608Metric | C27592 | UNI-ROYAL 0603WAF680JT5E
74LVC1G34 | U1 | SOT-353_SC-70-5 | C353880 | TI SN74LVC1G34DCKR
74LVC1G125 | U3 | SOT-353_SC-70-5 | C7833 | TI SN74LVC1G125DCKR
74LVC1G123 | U4 | VSSOP-8_2.3x2mm_P0.5mm | C352969 | TI SN74LVC1G123DCUR
TPS7B8133DRV | U5 | WSON-6-1EP_2x2mm_P0.65mm_EP1x1.6mm | C2876250 | TI TPS7B8133DRVR
LMR38020F | U6 | Texas_HSOP-8-1EP_3.9x4.9mm_P1.27mm_ThermalVias | C5149193 | TI LMR38020FDDAR
