Oleg-mk/JLR-MOST-Reader/reader_hw2/fab/most_reader_v2-bom.csv

Refs | Value | Footprint | Qty
C1 | 10u 100V | Capacitor_SMD:C_1210_3225Metric | 1
C2,C43,C46,C47,C82,C83,C84 | 100n 100V | Capacitor_SMD:C_0603_1608Metric | 7
C3 | 2u2 | Capacitor_SMD:C_0603_1608Metric | 1
C4 | 4u7 100V | Capacitor_SMD:C_1210_3225Metric | 1
C6,C8,C10,C12,C17,C19,C31,C64,C85 | 100n | Capacitor_SMD:C_0603_1608Metric | 9
C7 | 47u 10V | Capacitor_SMD:C_1210_3225Metric | 1
C9 | 1u | Capacitor_SMD:C_0603_1608Metric | 1
C18,C20 | 10u | Capacitor_SMD:C_0805_2012Metric | 2
C32 | 1u | Capacitor_SMD:C_0805_2012Metric | 1
C44 | 100u 63V | Capacitor_SMD:CP_Elec_10x10.5 | 1
C45 | 47u 63V | Capacitor_SMD:CP_Elec_8x10 | 1
C63 | 100u 16V | Capacitor_SMD:CP_Elec_6.3x7.7 | 1
D1,D3 | SS34 | Diode_SMD:D_SMA | 2
D2 | SMBJ36A | Diode_SMD:D_SMB | 1
F1 | 2A T | Fuse:Fuse_1206_3216Metric | 1
FB1,FB2 | 600R | Inductor_SMD:L_0603_1608Metric | 2
J1 | 1-1394640-1 | most_reader:TE_MOST_Pigtail_FOT_2+0 | 1
J4 | VBAT_IN | Connector_Molex:Molex_Micro-Fit_3.0_43650-0200_1x02_P3.00mm_Horizontal | 1
J6 | PLT237/T10WH | most_reader:Everlight_TOSLINK_T10 | 1
L1 | 15u | Inductor_SMD:L_Bourns_SRN6045TA | 1
L2 | 22u | Inductor_SMD:L_Bourns-SRN8040_8x8.15mm | 1
M1 | Tang Nano 20K | most_reader:Sipeed_TangNano20K | 1
R1,R2 | 150 | Resistor_SMD:R_0603_1608Metric | 2
R3,R42 | 27k | Resistor_SMD:R_0603_1608Metric | 2
R4,R6,R7 | 100k | Resistor_SMD:R_0603_1608Metric | 3
R5 | 23k2 | Resistor_SMD:R_0603_1608Metric | 1
R28,R43 | 33 | Resistor_SMD:R_0603_1608Metric | 2
R31 | 64k9 1% | Resistor_SMD:R_0603_1608Metric | 1
R44 | 68 | Resistor_SMD:R_0603_1608Metric | 1
U1 | 74LVC1G34 | Package_TO_SOT_SMD:SOT-353_SC-70-5 | 1
U3 | 74LVC1G125 | Package_TO_SOT_SMD:SOT-353_SC-70-5 | 1
U4 | 74LVC1G123 | Package_SO:VSSOP-8_2.3x2mm_P0.5mm | 1
U5 | TPS7B8133DRV | Package_SON:WSON-6-1EP_2x2mm_P0.65mm_EP1x1.6mm | 1
U6 | LMR38020F | Package_SO:Texas_HSOP-8-1EP_3.9x4.9mm_P1.27mm_ThermalVias | 1
