Oleg-mk/JLR-MOST-Reader/reader_hw2/caps/ring_cap.step

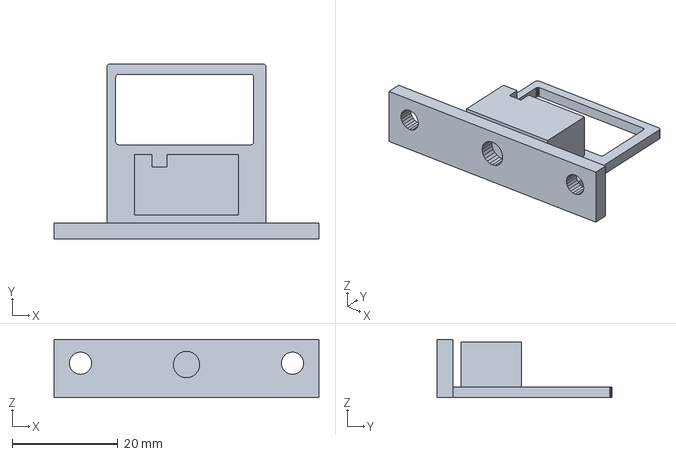
[picture p4: CAD file, 2026-10-11]
reader_hw2/caps/ring_cap.step
50.0 x 33.0 x 11.0 mm
