Oleg-mk/JLR-MOST-Reader/(list of files, cad)

Other CAD files:
reader_hw2/caps/far_cap.step
reader_hw2/caps/far_cap.stl
reader_hw2/caps/ring_cap.stl
