Oleg-mk/JLR-MOST-Reader/kit/2_fpga/BUILD.txt

reader.fs: the bitstream of the reader's FPGA, for the Tang Nano 20K's flash (README.md)
device     GW2AR-LV18QN88C8/I7
commit     db2b3aa91d16d0d15e99623a38c43ecaa24e0ec1
build_id   0DB2B3AA  (every STATUS record of the log carries it: ring_log shows it as 'build')
usercode   0x00009579  (over JTAG: Gowin Programmer, Read User Code)
loading    25.000MHz from the flash
built      2026-10-13 12:14
sha256     eb69fb60ad2e9ca5e7d612175a82b997c16ad0846026568377dcc73860208ca7
timing     ok    clk_s      needs   99.000 MHz, reaches  114.166 MHz, margin   15.3 % (min 10 %)
           TIMING: PASS
