Oleg-mk/JLR-MOST-Reader/reader_hw2/fab/most_reader_v2-assembly-top.pdf

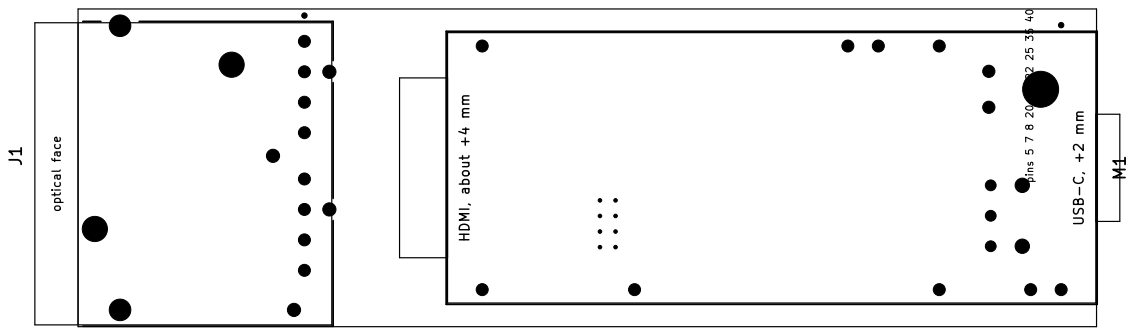
[picture p5: page 1]

optical face HDMI, about +4 mm pins 5 7 8 20 21 22 25 35 40 USB-C, +2 mm J1 M1
