Oleg-mk/JLR-MOST-Reader/reader_hw2/fab/most_reader_v2-schematic.pdf

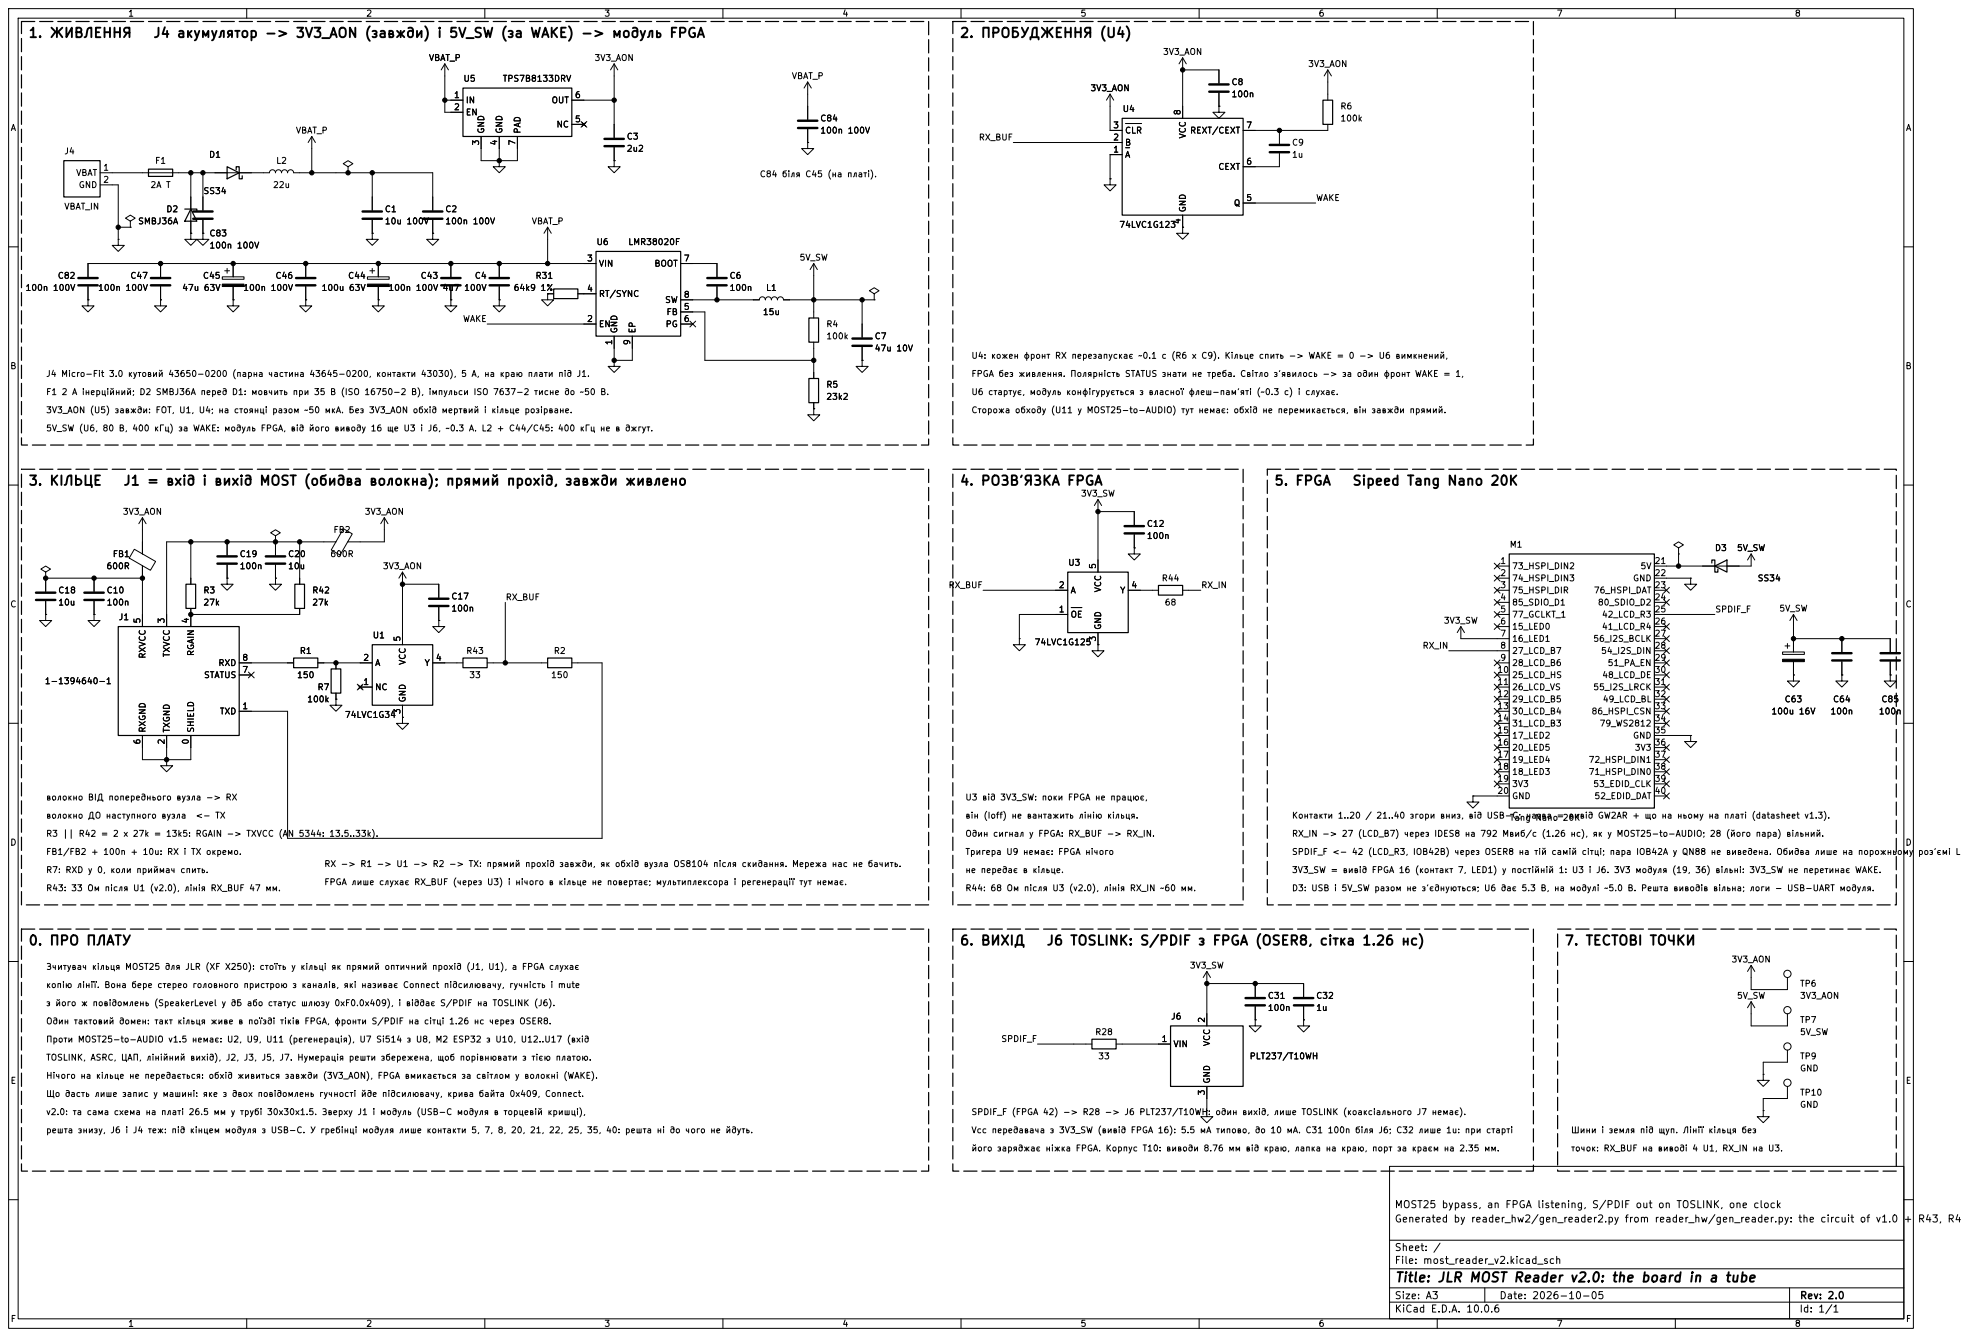
[picture p6: page 1]

U4: кожен фронт RX перезапускає ~0.1 с (R6 x C9). Кільце спить -> WAKE = 0 -> U6 вимкнений, FPGA без живлення. Полярність STATUS знати не треба. Світло з'явилось -> за один фронт WAKE = 1, U6 стартує, модуль конфігурується з власної флеш-пам'яті (~0.3 с) і слухає. Сторожа обходу (U11 у MOST25-to-AUDIO) тут немає: обхід не перемикається, він завжди прямий.

F1 2 А інерційний; D2 SMBJ36A перед D1: мовчить при 35 В (ISO 16750-2 B), імпульси ISO 7637-2 тисне до ~50 В.

волокно ВІД попереднього вузла -> RX

Контакти 1..20 / 21..40 згори вниз, від USB-C; назва = вивід GW2AR + що на ньому на платі (datasheet v1.3). v2.0: та сама схема на платі 26.5 мм у трубі 30x30x1.5. Зверху J1 і модуль (USB-C модуля в торцевій кришці),

він (Ioff) не вантажить лінію кільця.

Зчитувач кільця MOST25 для JLR (XF X250): стоїть у кільці як прямий оптичний прохід (J1, U1), а FPGA слухає R3 || R42 = 2 x 27k = 13k5: RGAIN -> TXVCC (AN 5344: 13.5..33k).

Тригера U9 немає: FPGA нічого

R44: 68 Ом після U3 (v2.0), лінія RX_IN ~60 мм.

TOSLINK, ASRC, ЦАП, лінійний вихід), J2, J3, J5, J7. Нумерація решти збережена, щоб порівнювати з тією платою. 0. ПРО ПЛАТУ

копію лінії. Вона бере стерео головного пристрою з каналів, які називає Connect підсилювачу, гучність і mute решта знизу, J6 і J4 теж: під кінцем модуля з USB-C. У гребінці модуля лише контакти 5, 7, 8, 20, 21, 22, 25, 35, 40: решта ні до чого не йдуть.

Проти MOST25-to-AUDIO v1.5 немає: U2, U9, U11 (регенерація), U7 Si514 з U8, M2 ESP32 з U10, U12..U17 (вхід

SPDIF_F (FPGA 42) -> R28 -> J6 PLT237/T10WH: один вихід, лише TOSLINK (коаксіального J7 немає). Vcc передавача з 3V3_SW (вивід FPGA 16): 5.5 мА типово, до 10 мА. C31 100n біля J6; C32 лише 1u: при старті його заряджає ніжка FPGA. Корпус T10: виводи 8.76 мм від краю, лапка на краю, порт за краєм на 2.35 мм.

точок: RX_BUF на виводі 4 U1, RX_IN на U3.

MOST25 bypass, an FPGA listening, S/PDIF out on TOSLINK, one clock
Generated by reader_hw2/gen_reader2.py from reader_hw/gen_reader.py: the circuit of v1.0 + R43, R44, C45 47u

Sheet: /
File: most_reader_v2.kicad_sch
Title: JLR MOST Reader v2.0: the board in a tube

Size: A3 | Rev: 2.0 | F Date: 2026-10-05
KiCad E.D.A. 10.0.6 | Id: 1/1
