Oleg-mk/JLR-MOST-Reader/kit/1_boards/most_reader-schematic.pdf

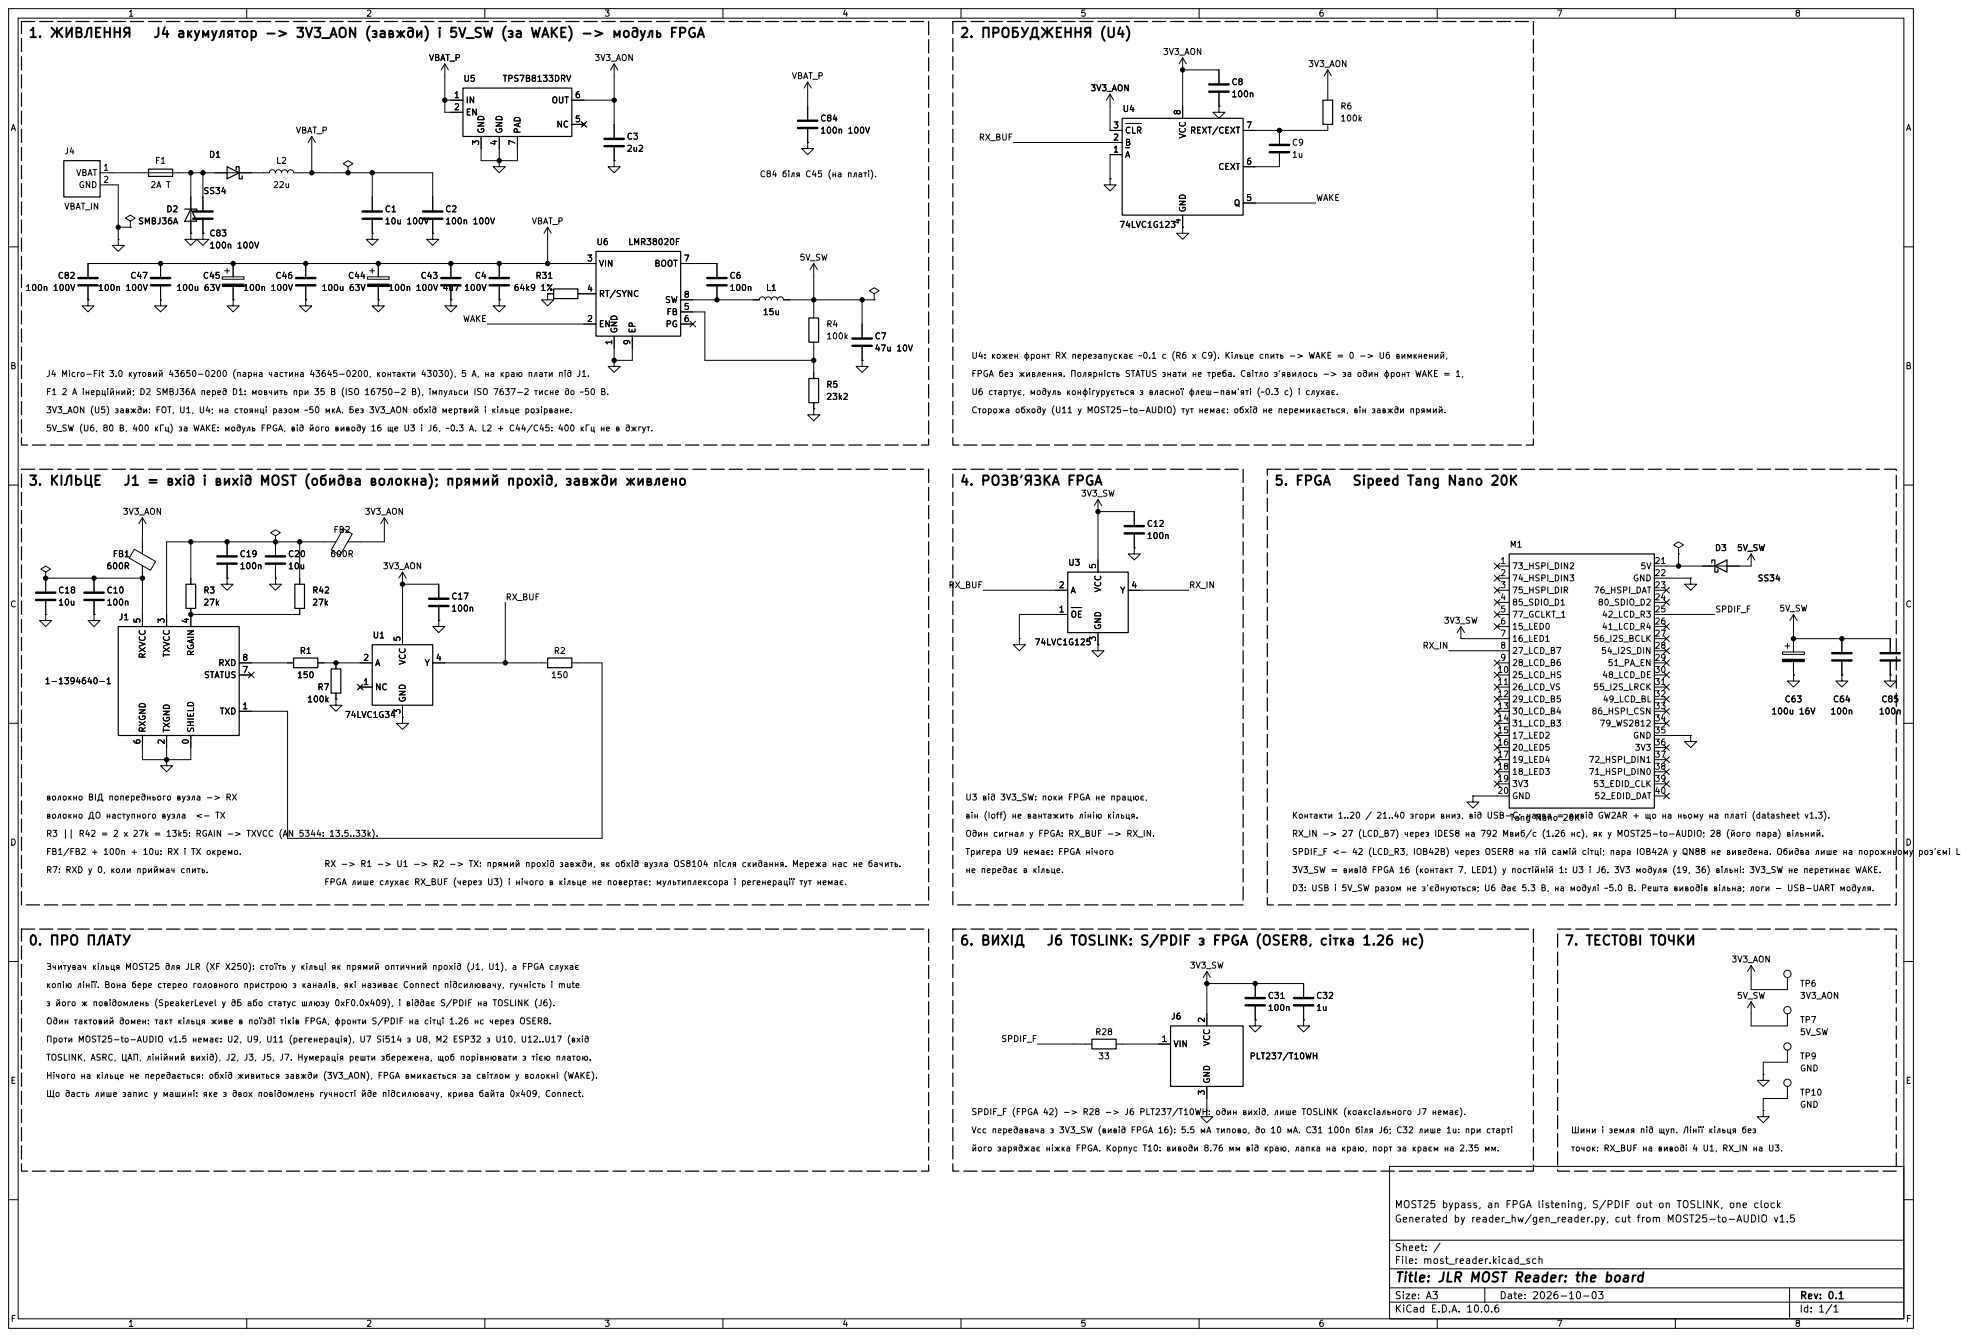
[picture p7: page 1]
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

5V_SW (U6, 80 В, 400 кГц) за WAKE: модуль FPGA, від його виводу 16 ще U3 і J6, ~0.3 А. L2 + C44/C45: 400 кГц не в джгут.

TOSLINK, ASRC, ЦАП, лінійний вихід), J2, J3, J5, J7. Нумерація решти збережена, щоб порівнювати з тією платою. R7: RXD у 0, коли приймач спить. волокно ВІД попереднього вузла -> RX Проти MOST25-to-AUDIO v1.5 немає: U2, U9, U11 (регенерація), U7 Si514 з U8, M2 ESP32 з U10, U12..U17 (вхід

точок: RX_BUF на виводі 4 U1, RX_IN на U3. U3 від 3V3_SW: поки FPGA не працює, він (Ioff) не вантажить лінію кільця. Один сигнал у FPGA: RX_BUF -> RX_IN. Тригера U9 немає: FPGA нічого

FB1/FB2 + 100n + 10u: RX і TX окремо. Зчитувач кільця MOST25 для JLR (XF X250): стоїть у кільці як прямий оптичний прохід (J1, U1), а FPGA слухає 0. ПРО ПЛАТУ

3V3_SW = вивід FPGA 16 (контакт 7, LED1) у постійній 1: U3 і J6. 3V3 модуля (19, 36) вільні: 3V3_SW не перетинає WAKE. SPDIF_F <- 42 (LCD_R3, IOB42B) через OSER8 на тій самій сітці; пара IOB42A у QN88 не виведена. Обидва лише на порожньому роз'ємі LCD. з його ж повідомлень (SpeakerLevel у дБ або статус шлюзу 0xF0.0x409), і віддає S/PDIF на TOSLINK (J6). R3 || R42 = 2 x 27k = 13k5: RGAIN -> TXVCC (AN 5344: 13.5..33k).

копію лінії. Вона бере стерео головного пристрою з каналів, які називає Connect підсилювачу, гучність і mute

Що дасть лише запис у машині: яке з двох повідомлень гучності йде підсилювачу, крива байта 0x409, Connect. Нічого на кільце не передається: обхід живиться завжди (3V3_AON), FPGA вмикається за світлом у волокні (WAKE).

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

MOST25 bypass, an FPGA listening, S/PDIF out on TOSLINK, one clock
Generated by reader_hw/gen_reader.py, cut from MOST25-to-AUDIO v1.5

Sheet: /
File: most_reader.kicad_sch
Title: JLR MOST Reader: the board

Size: A3 | Rev: 0.1 | F Date: 2026-10-03
KiCad E.D.A. 10.0.6 | Id: 1/1
