Oleg-mk/JLR-MOST-Reader/reader_hw2/fab/most_reader_v2-assembly-bottom.pdf

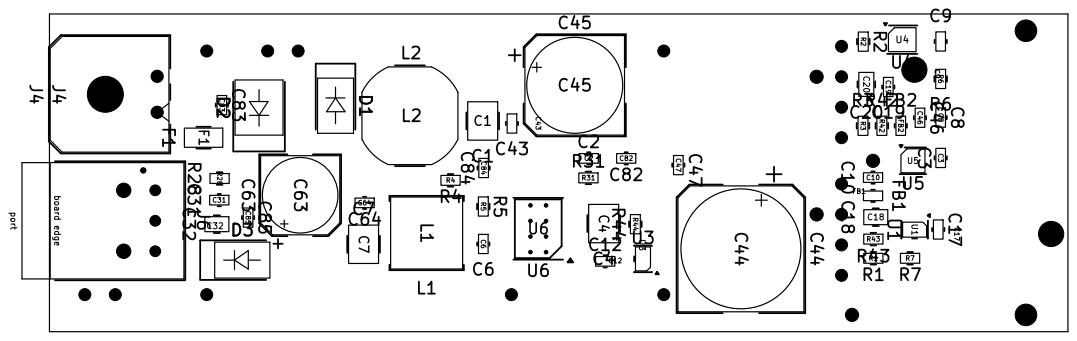
[picture p8: page 1]
