Oleg-mk/JLR-MOST-Reader/kit/1_boards/most_reader-assembly.pdf

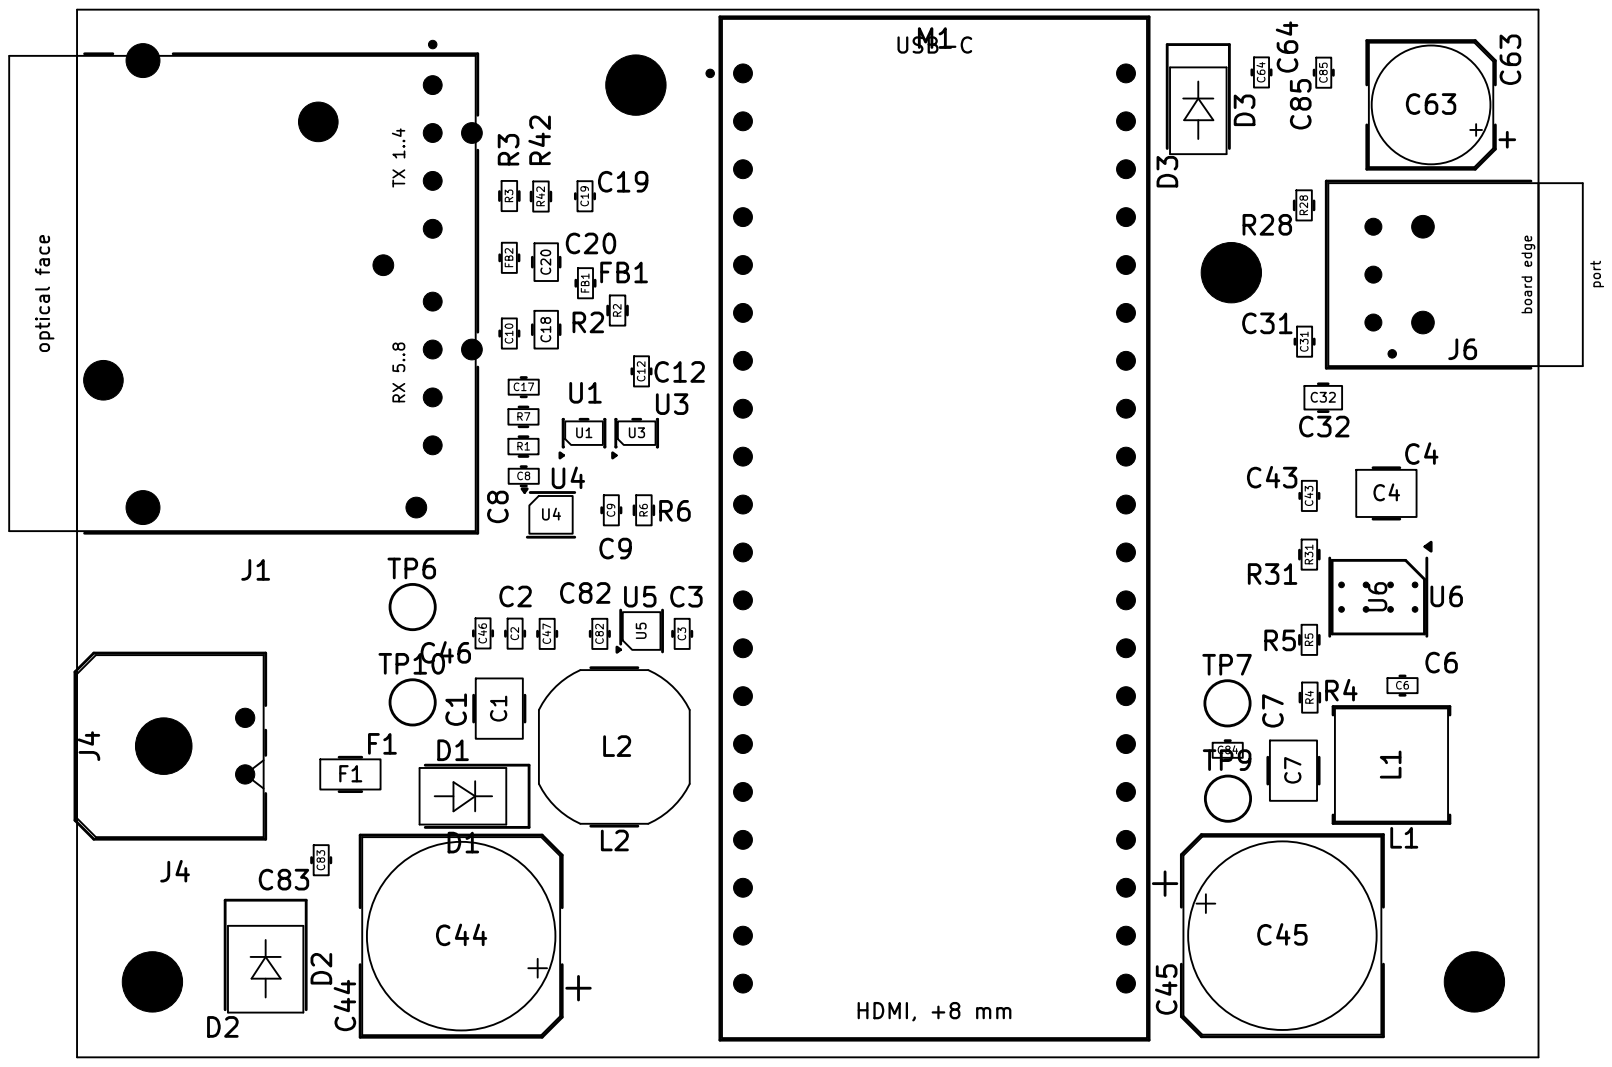
[picture p9: page 1]
