Oleg-mk/JLR-MOST-Reader/reader_hw2/most_reader_v2.kicad_pcb

## KiCad design reader_hw2/most_reader_v2.kicad_pcb (2026-10-10)

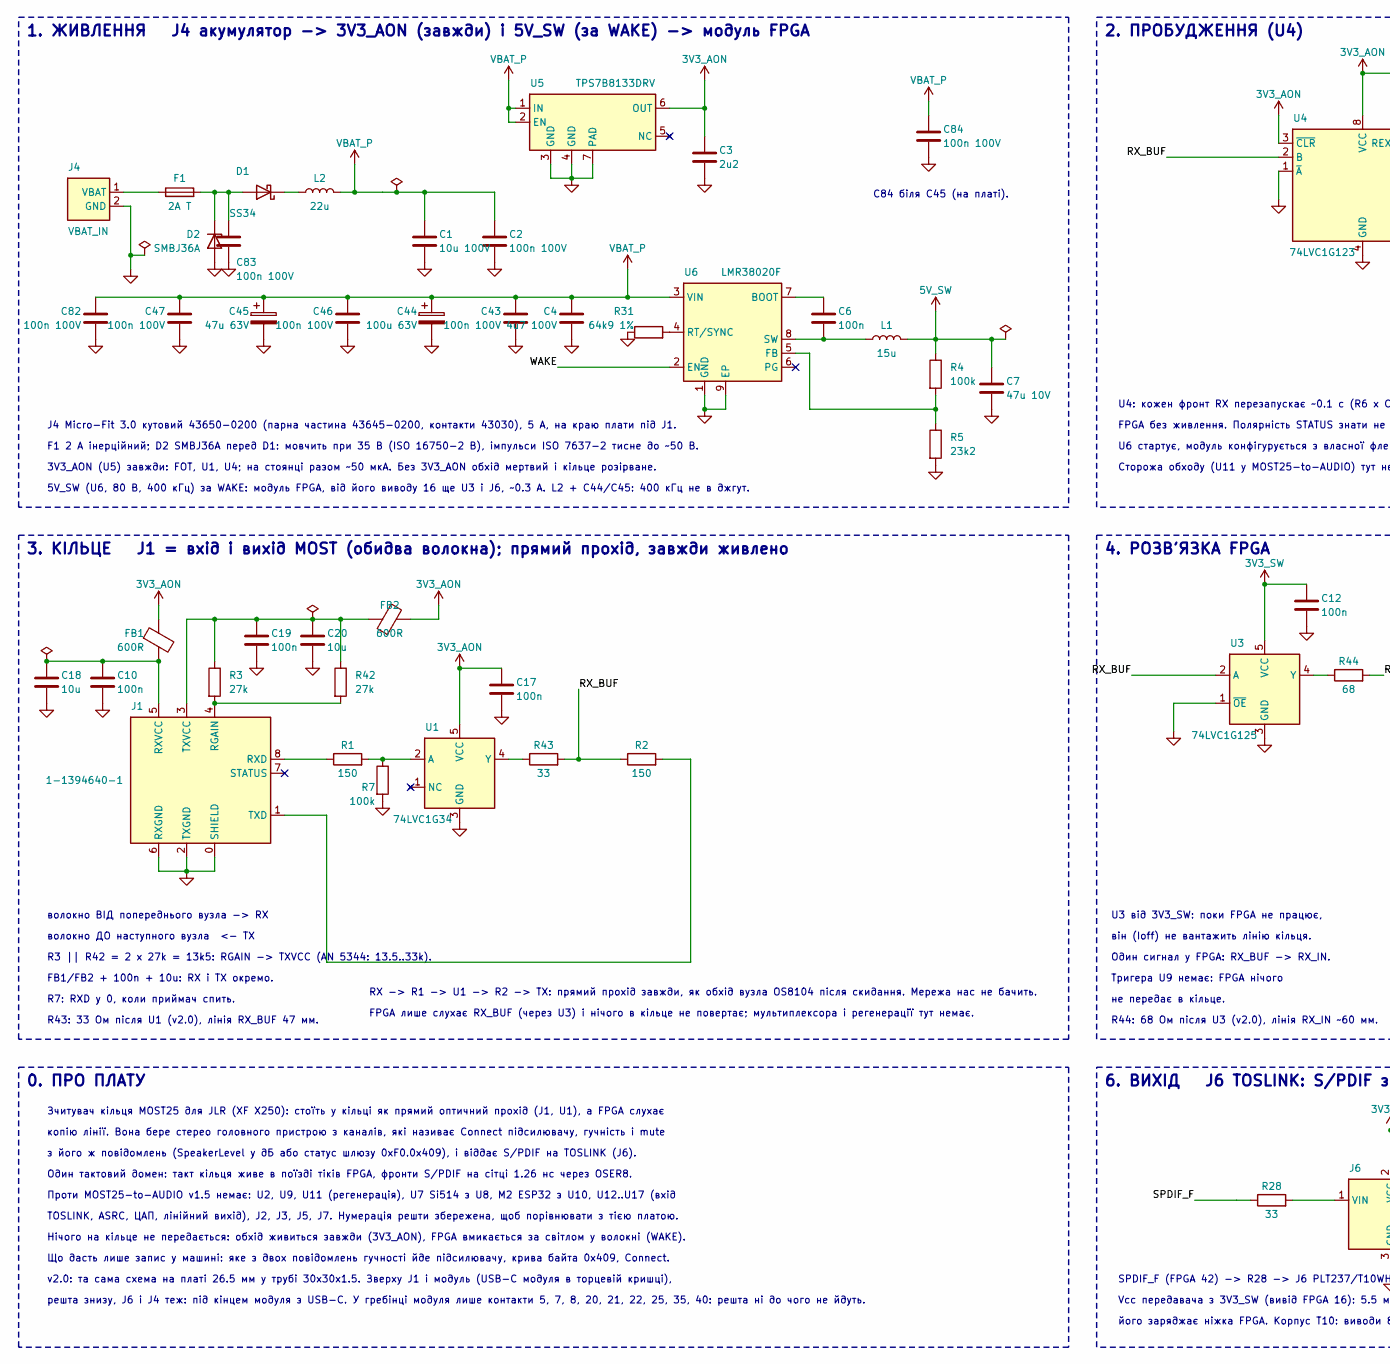
[picture p10: schematic most_reader_v2.kicad_sch, JLR MOST Reader v2.0: the board in a tube, part in row 1, column 1]

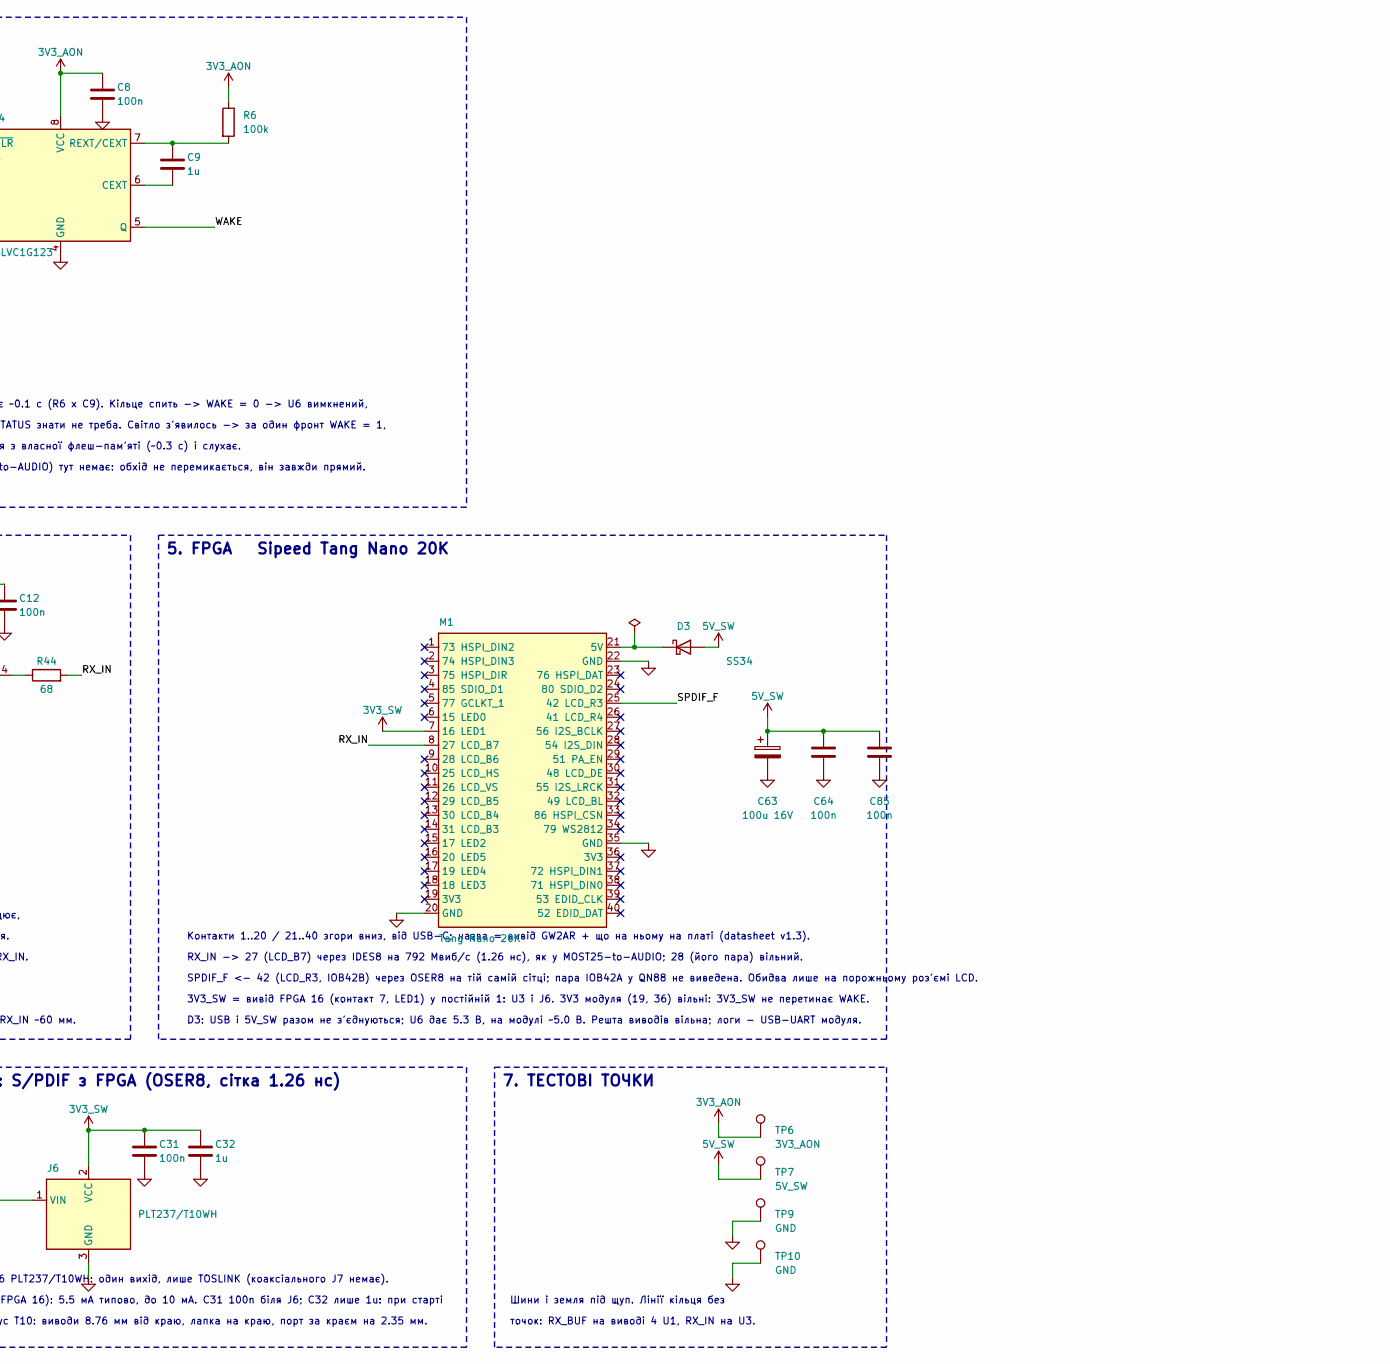
[picture p11: schematic most_reader_v2.kicad_sch, JLR MOST Reader v2.0: the board in a tube, part in row 1, column 2]

Parts:
C1: 10u 100V; C_1210_3225Metric
C2, C43, C46, C47, C82, C83, C84: 100n 100V; C_0603_1608Metric
C3: 2u2; C_0603_1608Metric
C4: 4u7 100V; C_1210_3225Metric
C6, C8, C10, C12, C17, C19, C31, C64, C85: 100n; C_0603_1608Metric
C7: 47u 10V; C_1210_3225Metric
C9: 1u; C_0603_1608Metric
C18, C20: 10u; C_0805_2012Metric
C32: 1u; C_0805_2012Metric
C44: 100u 63V; CP_Elec_10x10.5
C45: 47u 63V; CP_Elec_8x10
C63: 100u 16V; CP_Elec_6.3x7.7
D1, D3: SS34; D_SMA
D2: SMBJ36A; D_SMB
F1: 2A T; Fuse_1206_3216Metric
FB1, FB2: 600R; L_0603_1608Metric
J1: 1-1394640-1; TE_MOST_Pigtail_FOT_2+0
J4: VBAT_IN; Molex_Micro-Fit_3.0_43650-0200_1x02_P3.00mm_Horizontal
J6: PLT237/T10WH; Everlight_TOSLINK_T10
L1: 15u; L_Bourns_SRN6045TA
L2: 22u; L_Bourns-SRN8040_8x8.15mm
M1: Tang Nano 20K; Sipeed_TangNano20K
R1, R2: 150; R_0603_1608Metric
R3, R42: 27k; R_0603_1608Metric
R4, R6, R7: 100k; R_0603_1608Metric
R5: 23k2; R_0603_1608Metric
R28, R43: 33; R_0603_1608Metric
R31: 64k9 1%; R_0603_1608Metric
R44: 68; R_0603_1608Metric
TP6: 3V3_AON; TestPoint_Pad_D2.0mm
TP7: 5V_SW; TestPoint_Pad_D2.0mm
TP9, TP10: GND; TestPoint_Pad_D2.0mm
U1: 74LVC1G34; SOT-353_SC-70-5
U3: 74LVC1G125; SOT-353_SC-70-5
U4: 74LVC1G123; VSSOP-8_2.3x2mm_P0.5mm
U5: TPS7B8133DRV; WSON-6-1EP_2x2mm_P0.65mm_EP1x1.6mm
U6: LMR38020F; Texas_HSOP-8-1EP_3.9x4.9mm_P1.27mm_ThermalVias

Connections:
3V3_AON: C3.1, C8.1, C17.1, FB1.1, FB2.2, R6.1, TP6.1, U1.5 (VCC), U4.3 (~CLR), U4.8 (VCC), U5.6 (OUT)
3V3_SW: C12.1, C31.1, C32.1, J6.2 (VCC), M1.7 (16 LED1), U3.5 (VCC)
5V_SW: C7.1, C63.1, C64.1, C85.1, D3.2 (A), L1.2, R4.1, TP7.1
/RX_BUF: R2.1, R43.2, U3.2 (A), U4.2 (B)
/RX_IN: M1.8 (27 LCD_B7), R44.2
/SPDIF_F: M1.25 (42 LCD_R3), R28.1
/WAKE: U4.5 (Q), U6.2 (EN)
GND: C1.2, C2.2, C3.2, C4.2, C7.2, C8.2, C10.2, C12.2, C17.2, C18.2, C19.2, C20.2, C31.2, C32.2, C43.2, C44.2, C45.2, C46.2, C47.2, C63.2, C64.2, C82.2, C83.2, C84.2, C85.2, D2.2 (A), J1.0 (SHIELD), J1.2 (TXGND), J1.6 (RXGND), J4.2 (GND), J6.3 (GND), M1.20 (GND), M1.22 (GND), M1.35 (GND), R5.2, R7.2, R31.1, TP9.1, TP10.1, U1.3 (GND), U3.1 (~OE), U3.3 (GND), U4.1 (~A), U4.4 (GND), U5.3 (GND), U5.4 (GND), U5.7 (PAD), U6.1 (GND), U6.9 (EP)
unnamed: C83.1, D1.2 (A), D2.1 (K), F1.2
unnamed: D1.1 (K), L2.1
unnamed: D3.1 (K), M1.21 (5V)
unnamed: J1.4 (RGAIN), R3.2, R42.2
unnamed: J1.8 (RXD), R1.1
unnamed: C10.1, C18.1, FB1.2, J1.5 (RXVCC)
unnamed: J1.1 (TXD), R2.2
unnamed: C19.1, C20.1, FB2.1, J1.3 (TXVCC), R3.1, R42.1
unnamed: F1.1, J4.1 (VBAT)
unnamed: J6.1 (VIN), R28.2
unnamed: R1.2, R7.1, U1.2 (A)
unnamed: R43.1, U1.4 (Y)
unnamed: R44.1, U3.4 (Y)
unnamed: C9.2, U4.6 (CEXT)
unnamed: C9.1, R6.2, U4.7 (REXT/CEXT)
unnamed: C6.1, U6.7 (BOOT)
unnamed: R4.2, R5.1, U6.5 (FB)
unnamed: R31.2, U6.4 (RT/SYNC)
unnamed: C6.2, L1.1, U6.8 (SW)
VBAT_P: C1.1, C2.1, C4.1, C43.1, C44.1, C45.1, C46.1, C47.1, C82.1, C84.1, L2.2, U5.1 (IN), U5.2 (EN), U6.3 (VIN)

Notes on the sheet:
1. ЖИВЛЕННЯ J4 акумулятор -> 3V3_AON (завжди) і 5V_SW (за WAKE) -> модуль FPGA
J4 Micro-Fit 3.0 кутовий 43650-0200 (парна частина 43645-0200, контакти 43030), 5 А, на краю плати під J1.
F1 2 А інерційний; D2 SMBJ36A перед D1: мовчить при 35 В (ISO 16750-2 B), імпульси ISO 7637-2 тисне до ~50 В.
3V3_AON (U5) завжди: FOT, U1, U4; на стоянці разом ~50 мкА. Без 3V3_AON обхід мертвий і кільце розірване.
5V_SW (U6, 80 В, 400 кГц) за WAKE: модуль FPGA, від його виводу 16 ще U3 і J6, ~0.3 А. L2 + C44/C45: 400 кГц не в джгут.
C84 біля C45 (на платі).
2. ПРОБУДЖЕННЯ (U4)
U4: кожен фронт RX перезапускає ~0.1 с (R6 x C9). Кільце спить -> WAKE = 0 -> U6 вимкнений,
FPGA без живлення. Полярність STATUS знати не треба. Світло з'явилось -> за один фронт WAKE = 1,
U6 стартує, модуль конфігурується з власної флеш-пам'яті (~0.3 с) і слухає.
Сторожа обходу (U11 у MOST25-to-AUDIO) тут немає: обхід не перемикається, він завжди прямий.
3. КІЛЬЦЕ J1 = вхід і вихід MOST (обидва волокна); прямий прохід, завжди живлено
волокно ВІД попереднього вузла -> RX
волокно ДО наступного вузла <- TX
RX -> R1 -> U1 -> R2 -> TX: прямий прохід завжди, як обхід вузла OS8104 після скидання. Мережа нас не бачить.
FPGA лише слухає RX_BUF (через U3) і нічого в кільце не повертає; мультиплексора і регенерації тут немає.
R3 || R42 = 2 x 27k = 13k5: RGAIN -> TXVCC (AN 5344: 13.5..33k).
FB1/FB2 + 100n + 10u: RX і TX окремо.
R7: RXD у 0, коли приймач спить.
R43: 33 Ом після U1 (v2.0), лінія RX_BUF 47 мм.
4. РОЗВ'ЯЗКА FPGA
U3 від 3V3_SW: поки FPGA не працює,
він (Ioff) не вантажить лінію кільця.
Один сигнал у FPGA: RX_BUF -> RX_IN.
Тригера U9 немає: FPGA нічого
не передає в кільце.
R44: 68 Ом після U3 (v2.0), лінія RX_IN ~60 мм.
5. FPGA Sipeed Tang Nano 20K
Контакти 1..20 / 21..40 згори вниз, від USB-C; назва = вивід GW2AR + що на ньому на платі (datasheet v1.3).
RX_IN -> 27 (LCD_B7) через IDES8 на 792 Мвиб/с (1.26 нс), як у MOST25-to-AUDIO; 28 (його пара) вільний.
SPDIF_F <- 42 (LCD_R3, IOB42B) через OSER8 на тій самій сітці; пара IOB42A у QN88 не виведена. Обидва лише на порожньому роз'ємі LCD.
3V3_SW = вивід FPGA 16 (контакт 7, LED1) у постійній 1: U3 і J6. 3V3 модуля (19, 36) вільні: 3V3_SW не перетинає WAKE.
D3: USB і 5V_SW разом не з'єднуються; U6 дає 5.3 В, на модулі ~5.0 В. Решта виводів вільна; логи - USB-UART модуля.
6. ВИХІД J6 TOSLINK: S/PDIF з FPGA (OSER8, сітка 1.26 нс)
SPDIF_F (FPGA 42) -> R28 -> J6 PLT237/T10WH: один вихід, лише TOSLINK (коаксіального J7 немає).
Vcc передавача з 3V3_SW (вивід FPGA 16): 5.5 мА типово, до 10 мА. C31 100n біля J6; C32 лише 1u: при старті
його заряджає ніжка FPGA. Корпус T10: виводи 8.76 мм від краю, лапка на краю, порт за краєм на 2.35 мм.
7. ТЕСТОВІ ТОЧКИ
Шини і земля під щуп. Лінії кільця без
точок: RX_BUF на виводі 4 U1, RX_IN на U3.
0. ПРО ПЛАТУ
Зчитувач кільця MOST25 для JLR (XF X250): стоїть у кільці як прямий оптичний прохід (J1, U1), а FPGA слухає
копію лінії. Вона бере стерео головного пристрою з каналів, які називає Connect підсилювачу, гучність і mute
з його ж повідомлень (SpeakerLevel у дБ або статус шлюзу 0xF0.0x409), і віддає S/PDIF на TOSLINK (J6).
Один тактовий домен: такт кільця живе в поїзді тіків FPGA, фронти S/PDIF на сітці 1.26 нс через OSER8.
Проти MOST25-to-AUDIO v1.5 немає: U2, U9, U11 (регенерація), U7 Si514 з U8, M2 ESP32 з U10, U12..U17 (вхід
TOSLINK, ASRC, ЦАП, лінійний вихід), J2, J3, J5, J7. Нумерація решти збережена, щоб порівнювати з тією платою.
Нічого на кільце не передається: обхід живиться завжди (3V3_AON), FPGA вмикається за світлом у волокні (WAKE).
Що дасть лише запис у машині: яке з двох повідомлень гучності йде підсилювачу, крива байта 0x409, Connect.
v2.0: та сама схема на платі 26.5 мм у трубі 30x30x1.5. Зверху J1 і модуль (USB-C модуля в торцевій кришці),
решта знизу, J6 і J4 теж: під кінцем модуля з USB-C. У гребінці модуля лише контакти 5, 7, 8, 20, 21, 22, 25, 35, 40: решта ні до чого не йдуть.

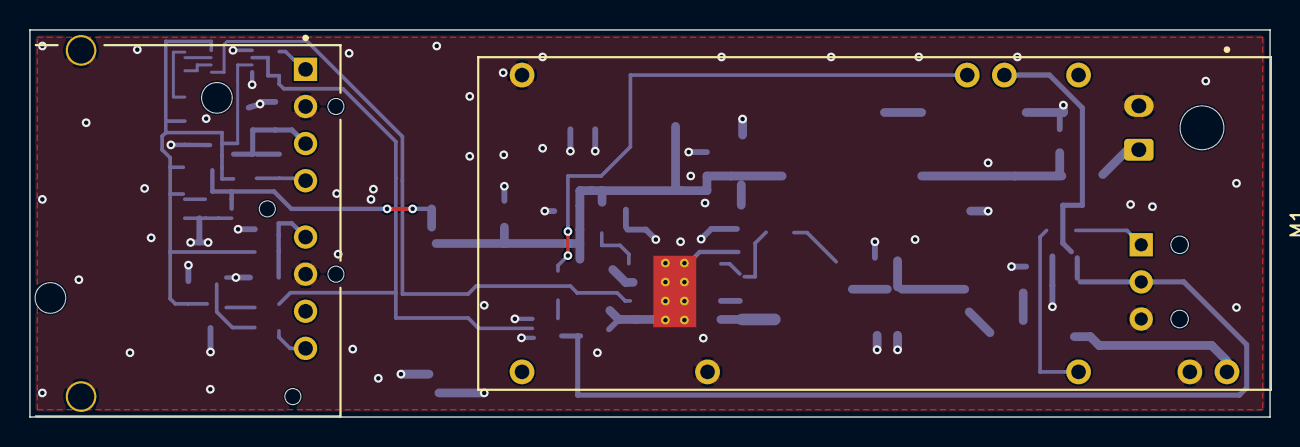
[picture p12: board most_reader_v2.kicad_pcb from above]

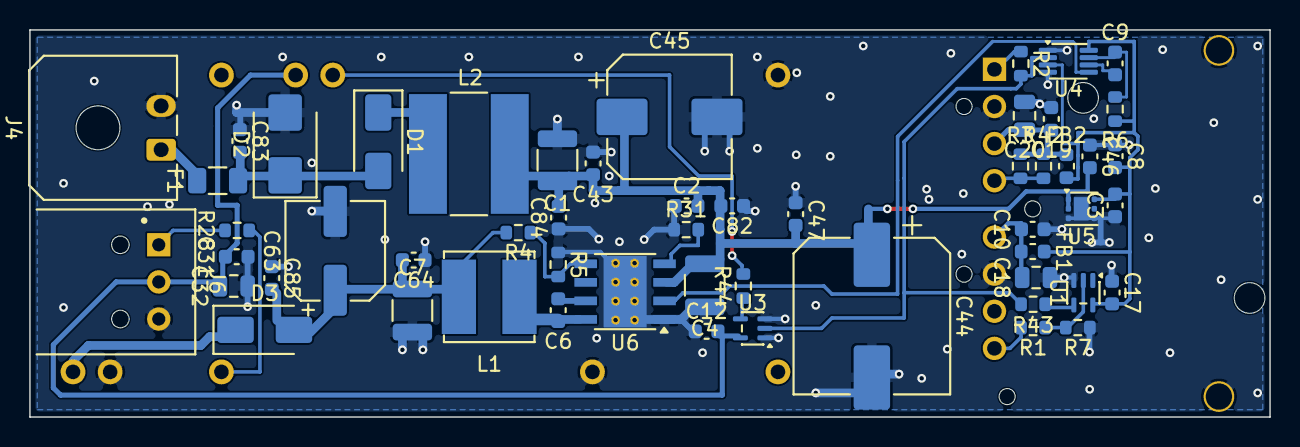
[picture p13: board most_reader_v2.kicad_pcb from below]

Board: 2 copper layers, 84.9 x 26.5 mm, 56 parts (54 on the bottom side), 28 nets.
