Oleg-mk/JLR-MOST-Reader/(commit log)

2026-10-03 Step 1, the model: a JLR-only MOST25 reader on one clock, from the line to S/PDIF
    virtual_most_source copied from MOST25-to-AUDIO 7ff5d2f and extended: control.py (a
    telegram into the 32-byte control block and back, segments, the block over 16 frames;
    the parser mirrors the host's most_msg.c rules) and jlr.py (the XF X250 messages the
    open projects saw, each with its source).
    reader_gw, the gateware on the receiver's 99 MHz alone, no ring-locked clock:
    - ctrl_decode.v reads the control channel in the FPGA: the frame parity learnt on the
    ring and demanded of every frame of a block; Connect, SinkInfo, DisConnect, Result,
    Error, Mute, SpeakerLevel and the gateway's 0xF0.0x409; amp_out's co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
    [amp_out.v, compare.py]
2026-10-03 Step 2, the board: the reader's sheet and the first layout
    reader_hw/gen_reader.py, cut from the listener's gen_listener.py, writes the one A3
    sheet most_reader.kicad_sch (54 parts, ERC 0 errors 0 warnings), the project symbol
    library, the FOT / TOSLINK T10 / Tang Nano 20K footprints with their 3D bodies and the
    library tables. Blocks: power without U10 and 5V_HOST, wake U4 without U11, the ring
    J1 + U1 straight RX -> TX without the mux U2, isolation U3 without U9, Tang Nano 20K
    with RX_IN on pin 27 (IDES8) and SPDIF_F on pin 42 (OSER8), J6 PLT133/T10W from 3V3_SW,
    test points, notes. The references of the shared parts are the listener's.
    reader_hw/gen_reader_pcb.py (KiCad's Python) lays mo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
    [most_reader.kicad_pcb, most_reader.kicad_sch]
2026-10-03 Step 2, the board routed: the user's placement, 77.54 x 55.55 mm, no jumper
    The layout is the board's own, not the listener's cut down. The user re-placed it six
    times on 2026-10-03 and cut 6.45 mm off the top. gen_reader_pcb.py's PLACE, REFPOS and
    TPTEXT now hold that placement, read back off the board, and --fresh on a copy lays
    every part where the board has it.
    Routing follows the listener's scheme. Every signal and supply runs on the top. The
    bottom is one unbroken ground plane with nothing but vias in it. The top pour is
    stitched every 6 mm, and every SMD ground pad has its own via.
    - The ring: RXD 4 mm from J1 to R1/U1, TXD up a lane to J1 pin 1, RX_BUF through U1's
    and U3's bodies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
    [most_reader.kicad_pcb, most_reader.kicad_sch]
2026-10-03 The gateware on the board: Tang Nano 20K top, pins, timing closed at 109.5 MHz
    reader_gw/board wraps the step 1 core for the module.
    - top_tangnano20k.v:
    - rPLL 27 MHz x 44/3 = 396 MHz, CLKDIV /4 = 99 MHz for the whole design;
    - power-on reset;
    - IDES8 on rx_in (pin 27, header 8) and OSER8 on spdif (pin 42, header 25);
    - pa_en held low, sw_vcc (pin 16, header 7) held high as 3V3_SW;
    - the status LEDs with pulse stretchers.
    - tangnano20k.cst and .sdc: the pins and the one clock domain.
    - build.tcl, build.py and check_timing.py: the Gowin batch build of reader.fs, which
    fails unless every clock meets its constraint with a 10 % margin. The build output in
    impl/ stays untracked.
    T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
    [amp_out.v, build.py, check_timing.py, ctrl_decode.v, dsp_core.v, nco_frame.v]
2026-10-03 The manufacturing package for 10 boards, fixed after a pre-order review
    reader_hw/make_fab.py, ported from the listener's, writes reader_hw/fab from the board
    and the sheet:
    - the Gerbers and both drill files, with a zip for the board house;
    - the BOM and the pick-and-place;
    - the same two in JLCPCB's format for SMD assembly: 27 lines, every part with the LCSC
    number chosen for the listener, none consigned;
    - a README with the board's numbers and the order steps.
    Every date in the files is the title-block date, so two runs give identical files.
    By hand after delivery: J1, J4, J6 and M1.
    An independent review of the package (Gerbers, assembly, parts) found two faults that
    would have ruined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
    [most_reader-B_Cu.gbl, most_reader-B_Mask.gbs, most_reader-Edge_Cuts.gm1, most_reader-F_Cu.gtl, most_reader-F_Mask.gts, most_reader-F_Paste.gtp, most_reader-F_Silkscreen.gto, most_reader-NPTH.drl]
2026-10-03 reader_hw/README: J6 runs from FPGA pin 16, 3 mA, not the module's 3.3 V at 20 mA
    The line predates the move of 3V3_SW to module pin 7 (FPGA pin 16, held high by the
    gateware). PLT133 takes 3 mA, 10 at most. It is powered and driven by the same FPGA, so
    its input is never driven while its supply is off. Found while checking the listener for
    the same back-drive.
2026-10-04 The ring log over the Tang Nano's USB-UART
    The FPGA sends what it sees on the ring and what it decides to pins 69/70 (the module's
    BL616 bridge to USB-C), 3 Mbaud 8N1; the board is unchanged. Records (LOGGING.md): every
    control block whole, every decoder decision and what the output did with it, the
    receiver's state every 21 ms, timed events, captures of the line around wake, wake + 2 s,
    unlock and of the frames on a new position or a mark. With the laptop attached the FPGA
    emulates the supply: after DARK the core is held, after the first edge it waits COLD ms.
    tools/ring_log.py records a trip, tools/log_decode.py parses it at home and replays the
    blocks through the decoder's model against t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
2026-10-04 FPGA timing that holds across builds; the log's byte activity checked bit for bit
    The build ID is a constant in every STATUS record, and another constant moves Gowin's
    placement: the same gateware rebuilt from the commit kept 1.9 % margin instead of 12 %.
    Builds with eight IDs found the paths placement can make slow; each was cut so that what
    goes out stays the same, but for the byte activity's interval, now a clock earlier:
    - diag_log: the byte compare a clock before the mask bit; the position trigger's zero
    test kept beside its counter; the peaks compared against all eight at once; STATUS's
    lane pick on its own copy of the writer's index; the writer's index cleared at the
    gap's end;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
2026-10-04 The laptop tools on macOS (Apple silicon too) and Windows 10, Python 3.8 or later
    ring_log.py read no keys on macOS (no marks, no quit; Ctrl+C hung) and fell back to a
    bare bell. Now, on both systems:
    - keys one at a time, also in a Ukrainian or Russian layout and with Caps Lock
    - each alarm its own tone (macOS: synthesised for afplay); the laptop and its screen
    kept awake (macOS: caffeinate in its own session, started again if it goes)
    - the bridge's UART found by its interface B; on Windows, a bridge whose B has no COM
    port is not taken for the UART (the JTAG's), with the fix on the screen
    - the status line cut to the window: the alarms first, then the state with the build,
    the count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
    [ctrl_model.py, log_decode.py, log_format.py, ring_log.py]
2026-10-04 J6: Everlight PLT237/T10WH on the same footprint; C32 1u; the fab package's PDFs
    The PLT133/T10W the board was drawn for is out of production (Everlight's last time buy
    2019-09-30, Rutronik; DigiKey has none and takes no backorder). The listener moved to
    Cliff ORJ-5/OTJ-5 because its receiver went too; this board has none, and the PLT133's
    successor in the same T10 housing, PLT237/T10WH (DPL-0000256 Rev.1), fits the footprint
    as it is: pins 1 Vin, 2 Vcc, 3 GND on 2.54, pegs 1.10 on 5.08 2.62 typ in front of them
    (the footprint's 2.63), 8.66 +-0.40 to the front foot (its 8.76). 2.7 to 5.0 V,
    -40 to +85 C (the Cliff part: -20 to +70), 10 mm tall (19), 5.5 mA typical, 10 at most,
    so FPGA pin 16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
    [most_reader-bom-jlcpcb.csv, most_reader-bom.csv, most_reader.kicad_pcb, most_reader.kicad_sch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]
2026-10-04 kit/: what the project hands over, kept equal to its sources
    Three folders to build the reader and drive with it without the rest of the repository,
    each with a README in Ukrainian:
    - 1_boards: the JLCPCB order (Gerbers, BOM and CPL with LCSC numbers), the full BOM,
    the schematic and the assembly drawing; the hand-soldered parts with part numbers and
    sources, what else the car needs, assembly, the checks before first power
    - 2_fpga: reader.fs of 5e9d61a (BUILD_ID 05E9D61A, 122.1 MHz, 23.3 %, loaded from the
    flash at 25 MHz) with BUILD.txt; writing the flash from Windows (Gowin Programmer)
    and from macOS (openFPGALoader), and how to tell which bitstream runs
    - 3_laptop: ring_log and l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
    [most_reader-bom-jlcpcb.csv, most_reader-bom.csv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]
2026-10-06 check_board: a footprint that differs from its symbol fails
    KiCad's parity check reports a footprint whose value or footprint differs from its symbol only
    as a warning, and check_board counted errors only: found while v2.0's R44 went from 33 to
    68 ohm, a board still carrying 33 passed against the sheet's 68, and the stale value would
    have reached the BOM. The DRC now runs at all severities; violations and unconnected items
    still count as errors only, parity items as errors plus footprint_symbol_mismatch. v1.0's
    board has no such warning and passes as before.
2026-10-06 reader v2.0: the board in a 30x30x1.5 tube, its fab package and kit
    reader_hw2/: v1.0's circuit plus two series resistors on a 26.5 x 95 mm two-layer board that
    slides into a 30x30x1.5 aluminium tube (27.0 inside) between two end caps.
    - The sheet: gen_reader2.py writes v1.0's blocks with v2.0's title and notes, the Tang Nano
    footprint without pads 1..4 (J4 sits under them) with the module's real overhangs and a 3D
    body, the FOT's action pins on 2.1 mm rings, and R43 33 ohm after U1 (RX_BUF) and R44 68 ohm
    after U3 (RX_IN): on two layers those lines are 100-130 ohm, and a line model of RX_IN gives
    13-31 % overshoot with 33 ohm, at most 8 % with 68. tools/check_v2_circuit.py shorts R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
    [most_reader_v2-B_Cu.gbl, most_reader_v2-B_Mask.gbs, most_reader_v2-B_Paste.gbp, most_reader_v2-B_Silkscreen.gbo, most_reader_v2-Edge_Cuts.gm1, most_reader_v2-F_Cu.gtl, most_reader_v2-F_Mask.gts, most_reader_v2-F_Silkscreen.gto]
2026-10-06 reader v2.0: the tube's end caps, from check_fit's model
    reader_hw2/gen_caps.py builds both caps of the 30x30x1.5 tube from check_fit.py's model of
    the board in it (check_fit must pass) and the board's leads, into reader_hw2/caps: a STEP and
    an STL of each (the print's frame: the outer face on the bed), caps.svg (each cap seen from
    outside and in section, the openings' table, the notes) and a README. No new dependency: the
    faces, the ear-clipped triangles and the STEP's planar B-rep are the script's own, run with
    KiCad's python.
    - A flange of the tube's outline, 30 mm square, 2.0 mm thick, corners R0.5 (the Kyiv stock's
    30x30x1.5, 6063 T6, has near-sharp corners), sits on the tube's end f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
    [far_cap.step, far_cap.stl, ring_cap.step, ring_cap.stl]
2026-10-06 reader v2.0: the tube bonded to ground by J4, through the far cap's screw
    The tube was floating: the caps are plastic and their screws go into plastic. It is now bonded
    to ground at the power entry: an M2 ring terminal and a serrated washer under the far cap's
    screw head, and a 3-5 cm wire to the GND wire of J4's harness by its plug, soldered and
    heat-shrunk; the same GND node as J4's pin 2, a few centimetres off. The board has no room for
    a bond of its own there (a PEM SMTRA right-angle nut was the candidate): the module's header
    rows run 2.2 mm from both long edges along the whole module, and J4 and J6 fill the end. The
    tube is to be raw, or its anodizing scraped off under the washer.
    The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
2026-10-10 reader v2.0: modernized - the board 84.9 mm, C45 8x10, the module on nine pins
    The user re-placed the parts in KiCad round by round and the copper followed:
    - power section: C6 between U6 and L1 (SW node 3.7 mm), C4 straight onto
    U6's VIN and exposed pad; C45 moved to the VBAT_P bus by U6
    - C45 47u 63V in 8x10 (SamYoung MVK, C165628) instead of 100u 10x10.5, made
    in gen_reader2.py; check_v2_circuit allows exactly this change
    - the module four header pins nearer J1, the board and tube 84.9 mm, J4 and
    J6 with the far edge; its footprint cut to nine pads (TANG_PINS)
    - far end placed by the user: D3 lying with SPDIF between its pads, 3V3_SW
    from pin 7 between F1's and R28's pads; /WAKE a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
    [most_reader_v2-B_Cu.gbl, most_reader_v2-B_Mask.gbs, most_reader_v2-B_Paste.gbp, most_reader_v2-B_Silkscreen.gbo, most_reader_v2-Edge_Cuts.gm1, most_reader_v2-F_Cu.gtl, most_reader_v2-F_Mask.gts, most_reader_v2-F_Silkscreen.gto]
2026-10-11 publication: English README, sources, licences, pictures of v2.0
    - README.md in English: what the reader is, which cars, how the ring's bypass
    works (it opens only if its KL30 supply is lost), what is proved and what is
    not, how to order and build, a rough cost; the Ukrainian one is README.uk.md
    - SOURCES.md: the open projects and documents the JLR and MOST25 knowledge
    comes from; nothing copied
    - licences: CERN-OHL-S-2.0 for the hardware and gateware, GPL-3.0-or-later for
    the software
    - reader_hw2/make_views.py: the board in its tube cut open, the closed tube's
    far end and the underside, rendered at basic quality into reader_hw2/views
    - gen_caps.py also writes caps_en.svg; both dr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
2026-10-11 v2.0 caps: a saddle to mount the tube by; BUILD.md, the build guide in English
    - each cap's flange runs on under the tube into a saddle, 3 mm thick and 9 mm
    along the tube, with a 10 mm ear either side and a 4.2 mm hole in each (4.2 mm
    self-tapping or M4); the ring cap's saddle clears its own screw's head. The
    tube rests on the two saddles; the caps still print outer face down, without
    supports (a tab past the end would lie below the bed)
    - the drawing at 2:1 with a view from below and the saddle's sizes; the ear
    clipping counts a point on an ear's edge, as the flange's foot and the
    saddle's ends lie on one line
    - BUILD.md: the kit's instructions in English, from ordering to the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
    [far_cap.step, far_cap.stl, ring_cap.step, ring_cap.stl]
2026-10-11 README: the car's own volume controls, applied digitally with no loss
    The opening says it, and a section right after the picture tells why it
    matters (the ring's audio comes before the volume) and why nothing is lost:
    the samples straight from the frames, the level in 32-bit arithmetic rounded
    once to the 24-bit output, no resampling, no DAC or ADC in between; plus the
    one open point, the 0x409 levels' curve.
2026-10-11 gateware: four streams - sink 4 (the chimes) and the parking sensors' own level
    mObridge's MOST25 DA guide (pp. 18-19) gives JLR's amplifier sinks: 1 the
    main source, 2 phone, navigation and voice, 3 the parking sensors, 4 the
    chimes. The decoder took sinks 1..3 only, so the chimes were lost.
    - ctrl_decode: sink 1..4 -> stream 0..3 for Connect, Result, Error,
    SinkInfo, DisConnect, Mute and SpeakerLevel; 0x409 byte 10 is the parking
    level (stream 2 takes it before byte 8); the chimes never take the volume,
    only their own SpeakerLevel or a fixed -6 dB; the coefficient set is 49
    words (gains 40..47, the commit at 48); dstate 19 bits
    - amp_out, dsp_core, dsp_asm: four streams out of the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
    [amp_out.v, ctrl_decode.v, ctrl_model.py, diag_log.v, dsp_asm.py, dsp_core.v, gain_tables.py]
2026-10-11 crosscheck_gains: the harness follows the C host's stream count
    It reads DSP_N_STREAMS from MOST25-to-AUDIO's dsp_map.h and builds the C
    harness for it: three streams (47 words) as the host is today, four (49
    words) once it takes sink 4 as the reader does. With four, every stream is
    compared under the reader's rules (byte 10 for the parking sensors, the
    chimes never on the volume); the exceptions for a three-stream host stay.
    Today's host: 7874 words equal, as before.
2026-10-11 trip instructions: a mark at every chime as well as at reverse gear
    Reverse gear and the chimes (key, seat belt, door) show on the first
    recording whether the parking tones and the chimes reach the amplifier as
    audio on sinks 3 and 4, which the reader plays, or as commands it turns
    into sound itself. BUILD.md, the kit's laptop README and LOGGING.md.
2026-10-11 README: a research project; the factory amplifier stays, the standard audio has no ring audio
    - the top says it is a research project: findings, recordings, corrections
    and help are welcome and go into the project
    - how the reader hears the audio: the head unit sends it to the factory
    amplifier, and on MOST it travels in channels any node can read
    - not for the standard audio: the head unit's own amplifier gets no ring
    audio (a forum member with SDD; mObridge's guide)
    - the factory amplifier: stays in the ring, powered; adding to the stock
    system changes nothing; taking its speakers over leaves speaker-open codes
    in it (an XKR with a commercial MOST interface), the rest still under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
2026-10-12 docs: what the cross-check with MOST25-to-AUDIO found, and no local paths
    MOST25-to-AUDIO, the listener the reader was cut down from, is public now. A
    cross-check of the two projects found these on the reader's side:
    - The listener is linked as public (README, SOURCES.md). README.uk.md's
    sources and jlr.py's citations name public projects, not local paths or
    notes. The two cross-check tools find the listener next to this repository
    (../MOST25-to-AUDIO, or MOST25_TO_AUDIO) and gcc on the PATH, else in
    ~/toolchains/mingw64 (or MINGW_GCC). gen_reader.py takes KiCad's symbols
    from KICAD10_SYMBOL_DIR or LOCALAPPDATA.
    - README: a Mute (0x113) is applied, not "mute works"; the amplifier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
2026-10-12 docs: prices, project history and kitchen notes out; README.uk.md is the README in Ukrainian
    What a builder or a contributor does not need is gone from the public
    documents:
    - README.uk.md was the project's journal (decisions, positions, the work
    log, audit notes); it is now the README translated into Ukrainian, and the
    journal stays in the history. README.md, reader_hw2/kit/README.md say so.
    - The rough-cost table (README) and dated stock levels (BUILD.md, the kits,
    the fab READMEs and make_fab.py).
    - Project history: the timing-closure story (reader_gw), the three dated
    routing rounds of v2.0 (reader_hw2/README.md is one section of the board as
    it stands: 496 mm of copper, 75 vi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
2026-10-13 README: the rough cost back; the bypass shares the board's 12 V input
    - Rough cost (README.md, README.uk.md): the table removed in aad9954, back
    with J1 at 22-27 USD (eBay about 22 on 2026-10-12, AliExpress about 27 on
    2026-10-13) and the fuse and wire for the 12 V tap in the small-parts row.
    The first reader comes to roughly 150-250 USD; a second one from the same
    order needs no new boards but still about 90-150 for its module, J1, hand
    parts, tube and cables (the old line said "only its hand parts and cables").
    - Is it safe for the car's ring: the bypass regulator U5 is fed through the
    board's 12 V input (F1, D1, L2) together with the buck U6 and the
    capacitors on VBAT_P, so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
2026-10-13 J3: the XF's 0x409 as JLR-HU reads it now, as the listener's 1f591e7
    JLR-HU's later code (rework-visuals-all-dab @ d6b46e2, AudioControl, from
    0b7dfa8) reads the gateway's 0xF0.0x409 Status differently from the parser
    the reader took (main @ 0359e58): byte 0 is the record's kind and only kind 0,
    the whole record, carries the levels; byte 2 is the volume, 0..35; bytes 7, 9,
    10 and 11 are the phone's, the navigation's, the voice's and the parking
    sensors' levels, each the level + 5, 0..25; a Set from the screen is
    [channel, 0, level + 5]. The reader gave the parking sensors byte 10, the
    voice's level, and took the bytes from any record.
    - ctrl_decode.v, ctrl_model.py: 0x409 from its Status al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
    [ctrl_decode.v, ctrl_model.py, gain_tables.py, log_format.py, run_ctrl.py, run_e2e.py]
